JasXSL/VibHub-ESP32/README.md

# VibHub-ESP32
Beefing up the HW of VibHub

This is the firmware for the ESP32 version.
If you're looking for the API documentation, you can find that on the original VibHub client git: 
https://github.com/JasXSL/VibHub-Client/wiki

Official website: https://vibhub.io
