JasXSL/VibHub-ESP32/VibHub32_1.0/2.1/21c_2.png

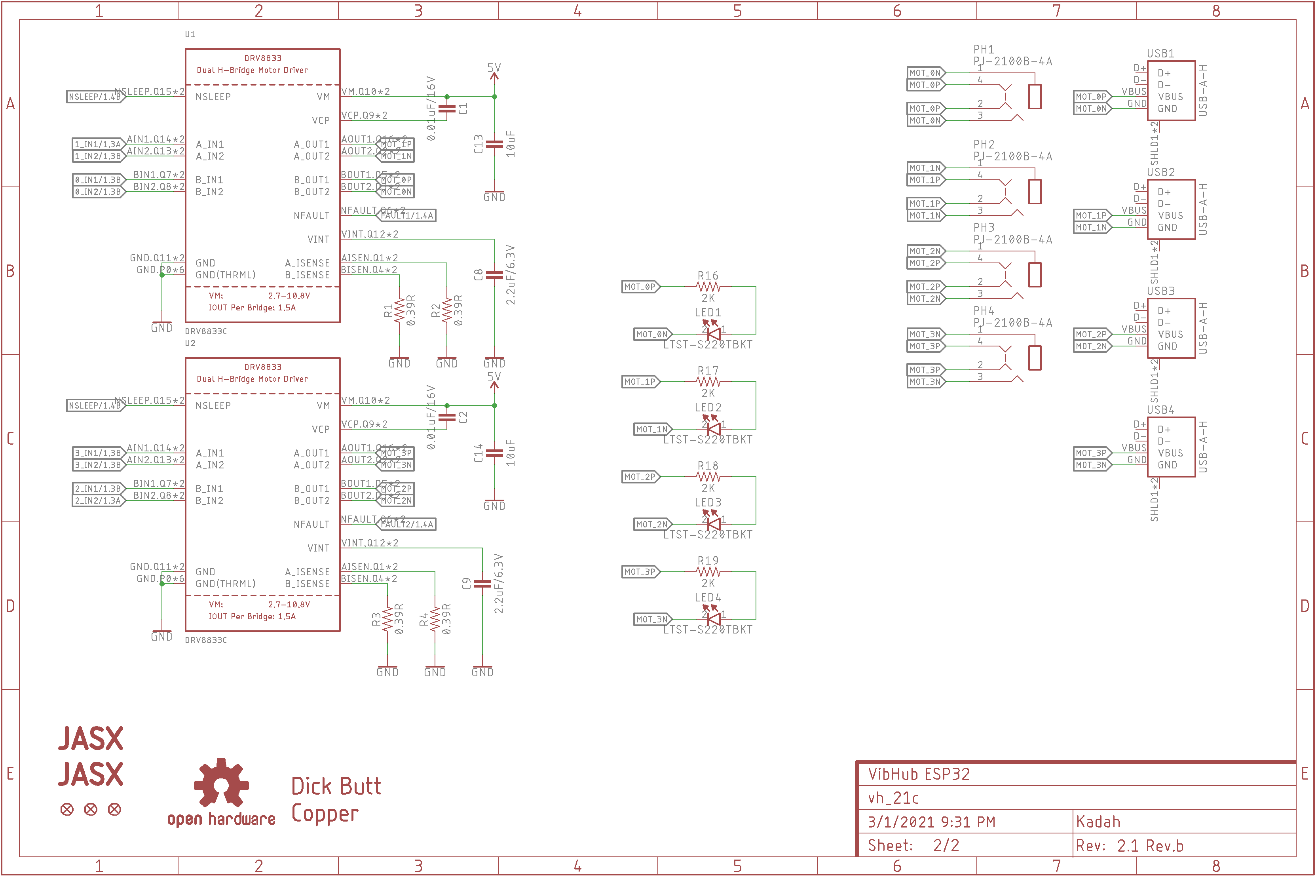
VibHub32_1.0/2.1/21c_2.png
