JasXSL/VibHub-ESP32/VibHub32_1.0/2.1/BOM.ods

Qty | Value | Device | Package | Parts | Description | Mgf | Mfg Part# | LCSC# | DigiKey# | Mouser# | Note
2 | 0.01uF (10nF) / 16V | CAPACITOR-0805 | C0805 | C1, C2 | Capacitors | Generic |  | C107135
3 | 10uF | CAPACITOR-0805 | C0805 | C12, C13, C14 | Capacitors | Generic |  | C15850
1 | 100uF / 10V | F931C107KCC | CAPPM6032X270N | C15 | Cap Tant Solid 100uF 16V C CASE 10% (6 X 3.2 X 2.5mm) Inward L SMD 6032-27 0.7 Ohm 125C T/R | AVX | F931C107KCC | C273664 | 478-8239-1-ND |  | Alt: C11375
2 | 0.1uF (100nF) | CAPACITOR-0805 | C0805 | C3, C4 | Capacitors | Generic |  | C1760
3 | 1.0uF | CAPACITOR-0805 | C0805 | C5, C6, C7 | Capacitors | Generic |  | C16834
4 | 2.2uF / 6.3V | CAPACITOR-0805 | C0805 | C8, C9, C10, C11 | Capacitors | Generic |  | C364318
1 | 1N4148W-7-F | DIODESOD-123 | SOD-123 | D1 | Diode | Diodes Incorporated | 1N4148W-7-F | C83528 | 1N4148W-7-F
2 | B340A-13-F | B340A | SMA | D3, D4 | Schottky diode | Diodes Incorporated | B340A-13-F | C85098 | B340A-FDICT-ND
1 | BAS70-05W,115 | BAS70-05SOT32 | SOT-23 | D5 | Silicon Schottky Diodes | Nexperia | BAS70-05W,115 | C34489 | 1727-4810-1-ND
1 | USBLC6-2SC6 | USBLC6-2SC6 | SOT-23-6 | ESD | TVS Diode Array Uni-Directional | STMicroelectronics | USBLC6-2SC6 | C7519 | 497-11882-1-ND |  | Optional, ESD protection for USB programming port
1 | 16V/2.5A | PPTC1812 | 1812 | F1 | Resettable Fuse PPTC | Bourns | MF-MSMF125-2 | C70120 | MF-MSMF125-2TR-ND |  | Any 1812 sized PTC between 2.2-2.5A
1 | DMG2305UX-13 | DMG2305UX-13 | SOT91P240X110-3 | Q1 | P-channel MOSFETs | Diodes Incorporated | DMG2305UX-13 | C144153 | DMG2305UX-13DICT-ND
1 | MBT3904DW1T1G | MBT3904DW1T1 | SC70-6 | Q2 | Dual NPN Transistors in Single Package | ON Semiconductor | MBT3904DW1T1G | C110150 | MBT3904DW1T1GOSCT-ND
1 | 2N7002,215 | MOSFET-NCH-BSS138 | SOT23-3 | Q3 | N-channel MOSFETs | Nexperia | 2N7002,215 | C65189 | 1727-2764-1-ND
4 | 0.30R to 0.40R | RESISTOR0805 | R0805 | R1, R2, R3, R4 | Generic Resistor Package | Generic |  | C247135 |  |  | Sets output current, see DRV8833 data sheet
2 | 22R | RESISTOR0805 | R0805 | R5, R6 | Generic Resistor Package | Generic |  | C107702
2 | 51R | RESISTOR0805 | R0805 | R7, R8 | Generic Resistor Package | Generic |  | C114537
5 | 220R | RESISTOR0805 | R0805 | R9, R10, R11, R12, R13 | Generic Resistor Package | Generic |  | C114519
2 | 1K | RESISTOR0805 | R0805 | R14, R15 | Generic Resistor Package | Generic |  | C100046
4 | 2K | RESISTOR0805 | R0805 | R16, R17, R18, R19 | Generic Resistor Package | Generic |  | C114748
12 | 10K | RESISTOR0805 | R0805 | R20, R21, R22, R23, R24, R25, R26, R27, R28, R29, R30, R31 | Generic Resistor Package | Generic |  | C84376
1 | >1M | RESISTOR0805 | R0805 | R32, R33 | Generic Resistor Package | Generic |  | C137463 |  |  | Pull-downs on battery input switching. 1M to 7M will work
2 | 150R (or 220R) | RESISTOR0805 | R0805 | R34, R35 | Generic Resistor Package | Generic |  | C114523 |  |  | 220R can be used instead to reuse existing BOM part
2 | DRV8833C | DRV8833 | HTSSOP16 or QFN16 | U1, U2 | DRV8833 Dual H-Bridge Motor Driver | Texas Instruments | DRV8833RTYR | C154936 | 296-29398-1-ND |  | HTSSOP16: C50506
1 | AP2112K-3.3V | V_REG_AP2112K-3.3V | SOT23-5 | U3 | 600mA CMOS LDO Regulator w/ Enable | Diodes Incorporated | AP2112K-3.3TRG1 | C51118 | AP2112K-3.3TRG1DICT-ND
1 | MAX16054AZT+T | MAX16054AZT+T | SOT95P275X110-6N | U4 | On Off Controller | Maxim Integrated | MAX16054AZT+T | C79401 | MAX16054AZT+TCT-ND |  | Optional if battery powered is not required
1 | CH340C | CH340C | SO016 | U5 | USB UART | WCH(Jiangsu Qin Heng) | CH340C | C84681 | I wish
4 | LTST-S220TBKT | LTST-S220TBKT | LTST-S220KFKT | LED1, LED2, LED3, LED4 | LED,0805,Side View,Blue,30mcd Lite-On LTST-S220TBKT Blue LED, 475 nm 2012 (0805) Side View, Rectangle Lens SMD package | Lite-On | LTST-S220TBKT-5A | C284936 | 160-2032-1-ND (too expensive, use standard 0805 LED instead) |  | Can be replaced with a standard 0805 LED
2 | RGB | LED-RGB-CAPLCC | P-LCC-4-3 | RGB1, RGB2 | LED-RGB Diffused Common Anode | Generic | 3528 RGB LED | C108539 | 732-4998-1-ND |  | https://www.aliexpress.com/item/32382711674.html
1 | ESP-WROOM32 | ESP-WROOM32 | ESP-WROOM32 | U6 | Espressif ESP-WROOM-32 | Espressif | ESP-WROOM-32 | C95209 | 1904-1010-1-ND
1 | USB-MICROB-2 | USB-MICROB-2 | USB-MICROB-10118194 | USB_IN | Micro USB Connector | Amphenol | 10118194-0001LF | C319164 | 609-4618-6-ND
2 | Right angle switch | MOMENTARY-SWITCH-SPST-RIGHTSQ75 | SW6X6_RIGHT_SQ73 | CONFIG, POWER | 6x6 right angle tact switch | Generic |  | C127680
2 | SMD tact switch | MOMENTARY-SWITCH-SPST-SMD-6.0X3.5MM | TACTILE_SWITCH_SMD_6.0X3.5MM | FLASH, RESET | SMD tact switch | Generic |  | C329185 |  |  | Or anything like this. Common button type. Can use different colors for flash and config to be fancy.
4* | USB-A-H | USB-A-H | USB-A-H | USB1, USB2, USB3, USB4 | USB Type A connector | Generic |  | C2346 |  |  | Pick any combination of 2.5mm and USB for a total of 4
4* | PJ-2100B-4A | PJ-2100B-4A | PJ2100B4A | PH1, PH2, PH3, PH4 | 2.5mm audio jack | Korean Hroparts Elec | PJ-2100B-4A | C145822 |  |  | “
4 | 596 | KEYSTONE_596 | THT | BATT_POS | Cylindrical Battery Contact | Keystone | 596 | C238144 | 36-596-ND | 534-596
4 | 590 | KEYSTONE_590 | THT | BATT_NEG | Cylindrical Battery Contact | Keystone | 590 | N/A as of May 2020 | 36-590-ND | 534-590
