JasXSL/VibHub-ESP32/VibHub32_1.0/2.1/Mini BOM.ods

Qty | Value | Package | Parts
2 | 0.01uF/16V | C0805 | C1, C2
3 | 10uF | C0805 | C12, C13, C14
1 | 100uF/10V | CAPPM | C15
2 | 0.1uF | C0805 | C3, C4
3 | 1.0uF | C0805 | C5, C6, C7
4 | 2.2uF/6.3V | C0805 | C8, C9, C10, C11
1 | 1N4148W-7-F | SOD-123 | D1
2 | B340A | SMA | D3, D4
1 | BAS70 | SOT-23 | D5
1 | USBLC6-2SC6 | SOT-23-6 | ESD
1 | 16V/2.2A | 1812 | F1
1 | DMG2305UX-13 | SOT-23 | Q1
1 | MBT3904DW1T1 | SC70-6 | Q2
1 | 2N7002,215 | SOT-23 | Q3
4 | 0.36R to 0.40R | R0805 | R1, R2, R3, R4
2 | 22R | R0811 | R5, R6
2 | 51R | R0813 | R7, R8
5 | 220R | R0810 | R9 thru R13
2 | 1K | R0809 | R14, R15
4 | 2K | R0812 | R16, R17, R18, R19
12 | 10K | R0807 | R20 thru R31
1 | >1M | R0806 | R32, R33
2 | 150R (or 220R) | R0808 | R34, R35
2 | DRV8833C | COMBO | U1, U2
1 | AP2112K-3.3V | SOT-23-5 | U3
1 | MAX16054AZT+T | SOT-23-6 | U4
1 | CH340C | SO-16 | U5
4 | LTST-S220TBKT | 2.1x1x0.6 | LED1 thru LED4
2 | RGB | P-LCC-4-3 | RGB1, RGB2
1 | ESP-WROOM32 | WROOM32 | U6
