JasXSL/VibHub-ESP32/VibHub32_1.0/2.0a/BOM.ods

Qty | Value | Device | Package | Parts | Description | DIGIKEY | PROD_ID | VALUE
1 | BC4AAPCBC4AAPC | BC4AAPCBC4AAPC | BC4AAPC | BAT
2 | 0.01uF/16V | CAPACITOR-0805 | C0805 | C1, C2 | Capacitors
1 | 4.7uF | CAPACITOR-0805 | C0805 | C12 | Capacitors
3 | 10uF | CAPACITOR-0805 | C0805 | C13, C14, C15 | Capacitors
1 | 100uF/10V | CAPACITOR_POLPANASONIC_D | PANASONIC_D | C16 | Polarized Capacitors
2 | 0.1uF | CAPACITOR-0805 | C0805 | C3, C4 | Capacitors
3 | 1.0uF | CAPACITOR-0805 | C0805 | C5, C6, C7 | Capacitors
4 | 2.2uF/6.3V | CAPACITOR-0805 | C0805 | C8, C9, C10, C11 | Capacitors
4 | MJ-2509N | MJ-2509N | MJ-2509N | CH_0, CH_1, CH_2, CH_3 | Mono Audio Jack, 2.5 MM
4 | USB-A-H | USB-A-H | USB-A-H | CH_0U, CH_1U, CH_2U, CH_3U | USB Connectors
4 | MOMENTARY-SWITCH-SPST-RIGHTSQ75 | MOMENTARY-SWITCH-SPST-RIGHTSQ75 | SW6X6_RIGHT_SQ73 | CONFIG, FLASH, POWER, RESET
1 | RGB | LED-RGB-CAPLCC | P-LCC-4-3 | D1 | LED-RGB Diffused Common Anode |  | DIO-12986 | RGB
2 | 3A/40V/500mV | DIODE-SCHOTTKY-B340A | SMA-DIODE | D2, D3 | Schottky diode |  | DIO-09886 | 3A/40V/500mV
1 | BAS70-05SOT32 | BAS70-05SOT32 | SOT91P240X110-3 | D4 | Silicon Schottky Diodes
1 | D_ESD5V3U2U-03F | D_ESD5V3U2U-03F | SOT723 | D5 | TVS Diode - Uni-directional Ultra Low ESD / Transient Protection Diode | ESD5V3U2U-03F H6327DKR-ND
8 | Blue | LED0805 | CHIPLED_0805 | D6, D7, D8, D9, D10, D11, D12, D13 | LED (Generic)
1 | 16V/2.2A | PPTC1812 | FUSC7035X90 | F1 | Resettable Fuse PPTC
1 | USB-MICROB-2 | USB-MICROB-2 | USB-MICROB-10118194 | J1 | USB Connectors | 609-4618-6-ND
3 |  | CONN_07X2 | 2X7 | J2, J6, J7 | Multi connection point. Often used as Generic Header-pin footprint for 0.1 inch spaced/style header connections
1 |  | CONN_04 | 1X04 | J3 | Multi connection point. Often used as Generic Header-pin footprint for 0.1 inch spaced/style header connections |  | CONN-09696
1 | 1x8M | CONN_06LOCK | 1X06_LOCK | PROG | Multi connection point. Often used as Generic Header-pin footprint for 0.1 inch spaced/style header connections
1 | MOSFET_PCH-DMG2305UX-13 | MOSFET_PCH-DMG2305UX-13 | SOT91P240X110-3 | Q1 | P-channel MOSFETs
1 |  | TRANS_NPN_DUAL-MBT3904DW1T1 | SC70-6 | Q2 | Dual NPN Transistors in Single Package |  | TRANS-13337
4 | 0.39R | RESISTOR0805 | 805 | R1, R2, R3, R4 | Generic Resistor Package
10 | 1K | RESISTOR0805 | 805 | R11, R12, R13, R14, R15, R16, R17, R18, R19, R20 | Generic Resistor Package
12 | 10K | RESISTOR0805 | 805 | R21, R22, R23, R24, R25, R26, R27, R28, R29, R30, R31, R32 | Generic Resistor Package
1 | 15K | RESISTOR0805 | 805 | R33 | Generic Resistor Package
3 | 100K | RESISTOR0805 | 805 | R34, R35, R36 | Generic Resistor Package
1 | 22R | RESISTOR0805 | 805 | R5 | Generic Resistor Package
1 | 51R | RESISTOR0805 | 805 | R6 | Generic Resistor Package
4 | 220R | RESISTOR0805 | 805 | R7, R8, R9, R10 | Generic Resistor Package
2 | DRV8833C | DRV8833 | HTSSOP16 | U1, U2 | DRV8833 Dual H-Bridge Motor Driver -- HTSSOP Package
1 | 3.3V | V_REG_AP2112K-3.3V | SOT23-5 | U3 | AP2112 - 600mA CMOS LDO Regulator w/ Enable |  | VREG-12457 | 3.3V
1 | CP2102N-QFN24 | CP2102N-QFN24 | QFN24-PAD | U4 | Silabs CP2102N USB to UART Bridge (5V tolerant inputs)
1 | 4093SO14 | 4093SO14 | SOIC127P600X175-14 | U5 | Quad 2-input NAND schmitt trigger
1 | ESP-WROOM32 | ESP-WROOM32 | ESP-WROOM32 | U6 | Espressif ESP-WROOM-32 ESP32 WiFi/WLAN + Bluetooth/BLE Module
