JasXSL/VibHub-ESP32/VibHub32_1.0/2.0a/Case/Case Bottom.stl

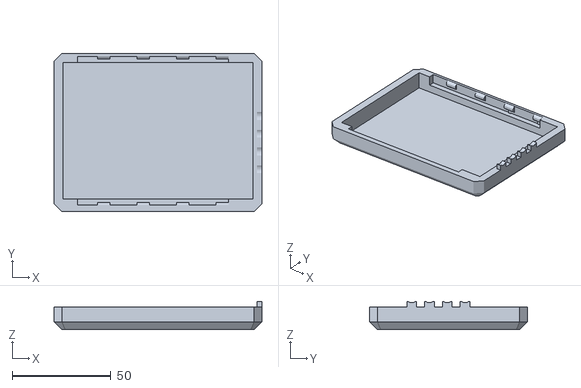
[picture p3: CAD file, 2019-07-22]
VibHub32_1.0/2.0a/Case/Case Bottom.stl
105.1 x 79.9 x 14.4
