JasXSL/VibHub-ESP32/VibHub32_1.0/2.0a/Case/With Logo/Case Top - Logo.stl

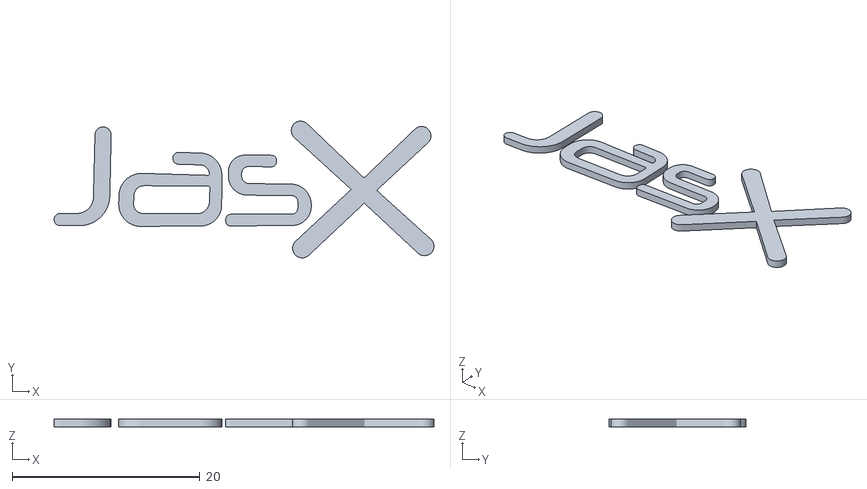
[picture p4: CAD file, 2019-07-22]
VibHub32_1.0/2.0a/Case/With Logo/Case Top - Logo.stl
40.5 x 14.6 x 0.8
