JasXSL/VibHub-ESP32/VibHub32_1.0/2.1/Case/Bottom_Tight.stl

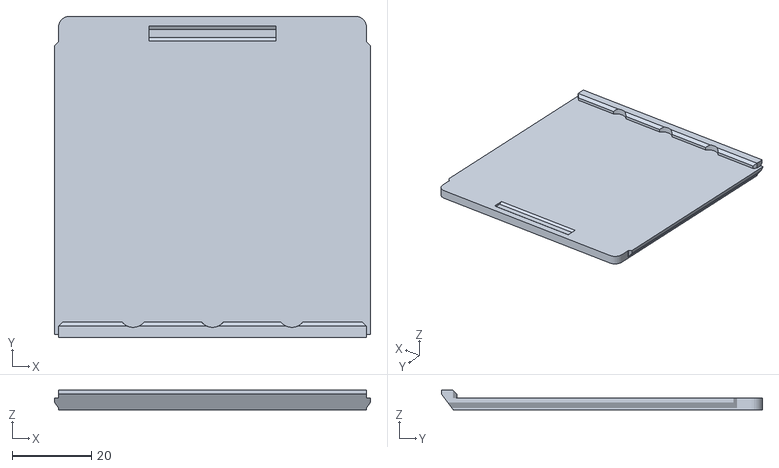
[picture p5: CAD file, 2020-05-22]
VibHub32_1.0/2.1/Case/Bottom_Tight.stl
79.6 x 80.9 x 4.95
