JasXSL/VibHub-ESP32/VibHub32_1.0/2.1/Case/Top v12 Thinner Face Multi Material/Top_Vibhub 2.1c Case rev F v12_22_Top.stl

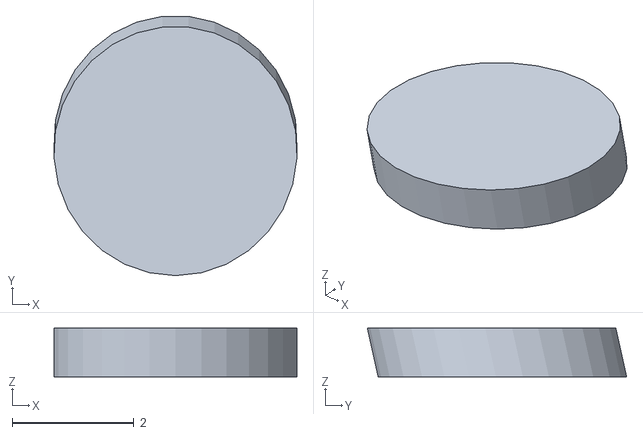
[picture p7: CAD file, 2020-05-22]
VibHub32_1.0/2.1/Case/Top v12 Thinner Face Multi Material/Top_Vibhub 2.1c Case rev F v12_22_Top.stl
3.99 x 4.26 x 0.8
