JasXSL/VibHub-ESP32/VibHub32_1.0/2.1/Case/Top v9 Thiner Logo Multi Material/Top_Vibhub 2.1c Case rev F v9_l6_Top.stl

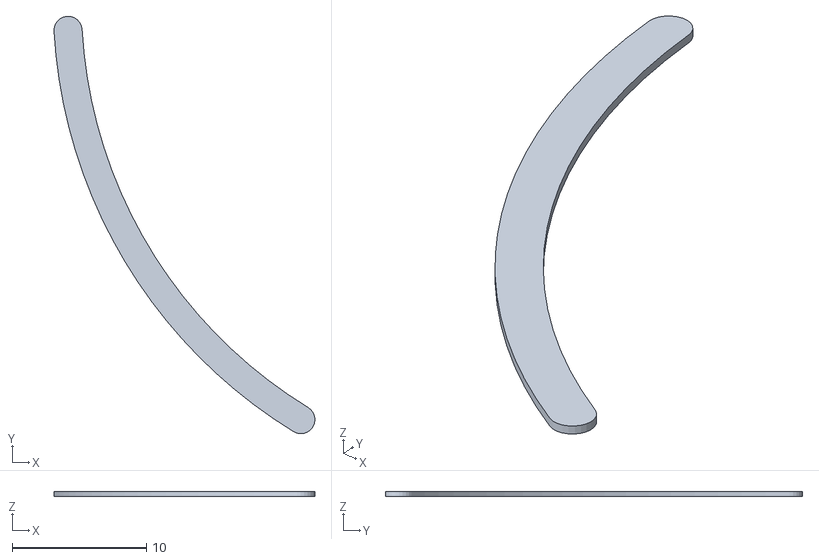
[picture p8: CAD file, 2020-05-19]
VibHub32_1.0/2.1/Case/Top v9 Thiner Logo Multi Material/Top_Vibhub 2.1c Case rev F v9_l6_Top.stl
19.4 x 31.1 x 0.4
