JasXSL/VibHub-ESP32/VibHub32_1.0/2.0a/Case/Port Jig.stl

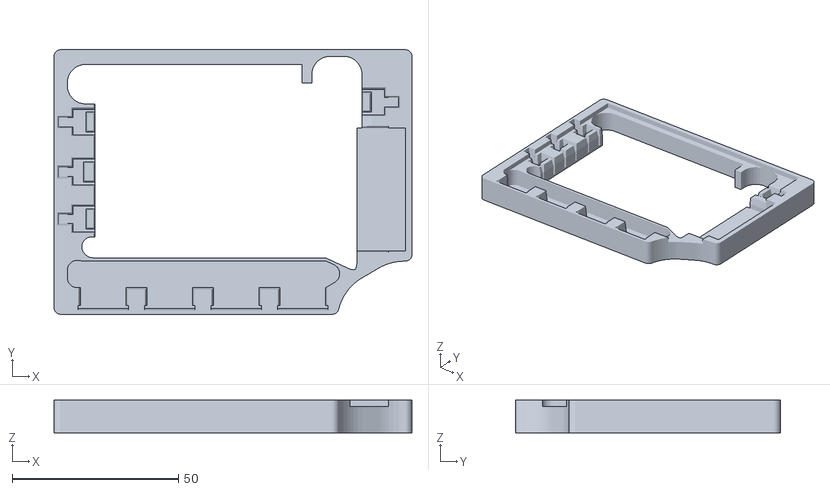
[picture p9: CAD file, 2019-07-22]
VibHub32_1.0/2.0a/Case/Port Jig.stl
107.7 x 79.6 x 9.92
