JasXSL/VibHub-ESP32/VibHub32_1.0/2.0a/Case/With Logo/Case Top - No Vents.stl

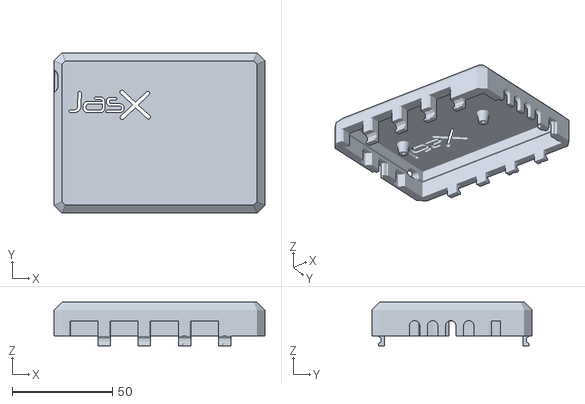
[picture p10: CAD file, 2019-07-22]
VibHub32_1.0/2.0a/Case/With Logo/Case Top - No Vents.stl
105.1 x 79.9 x 21.9
