JasXSL/VibHub-ESP32/VibHub32_1.0/2.1/Case/Top Single.stl

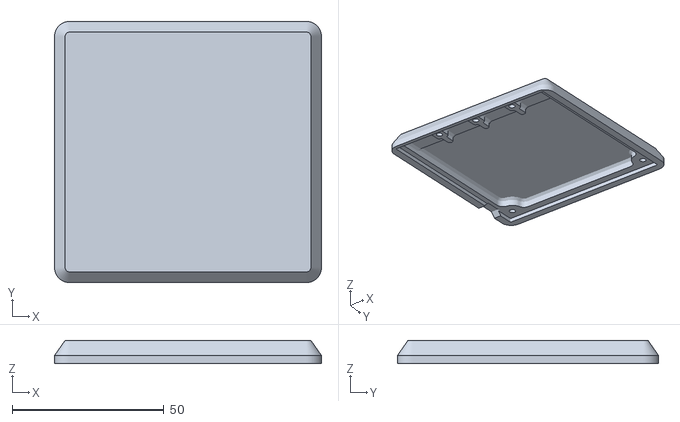
[picture p11: CAD file, 2020-05-19]
VibHub32_1.0/2.1/Case/Top Single.stl
88.0 x 86.1 x 7.67
