JasXSL/VibHub-ESP32/VibHub32_1.0/2.1/Case/Top v10 Thiner Logo Thinner Face Multi Material/Top_Vibhub 2.1c Case rev F v10_vb_Top.stl

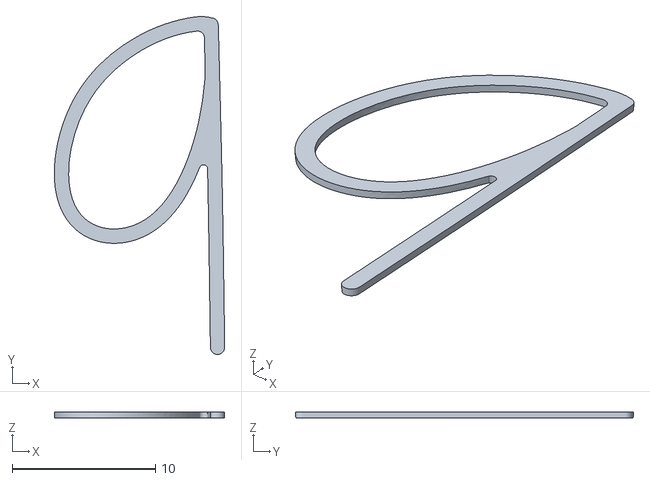
[picture p12: CAD file, 2020-05-22]
VibHub32_1.0/2.1/Case/Top v10 Thiner Logo Thinner Face Multi Material/Top_Vibhub 2.1c Case rev F v10_vb_Top.stl
11.9 x 23.6 x 0.4
