JasXSL/VibHub-ESP32/VibHub32_1.0/2.1/Case/Top v12 Thinner Face Multi Material/Top_Vibhub 2.1c Case rev F v12_33_Top.stl

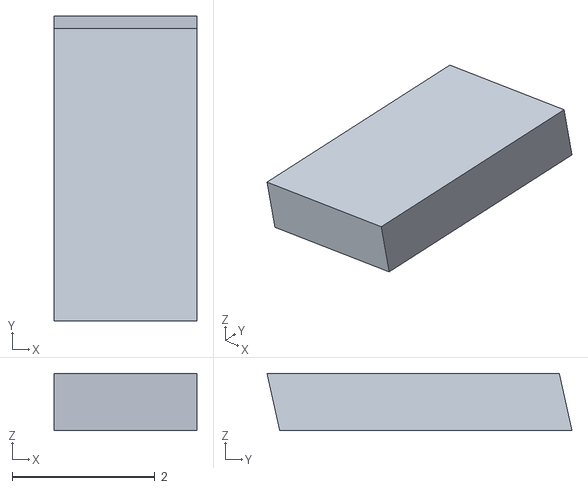
[picture p13: CAD file, 2020-05-22]
VibHub32_1.0/2.1/Case/Top v12 Thinner Face Multi Material/Top_Vibhub 2.1c Case rev F v12_33_Top.stl
2.00 x 4.27 x 0.8
