JasXSL/VibHub-ESP32/VibHub32_1.0/2.0a/Case/Buttons.stl

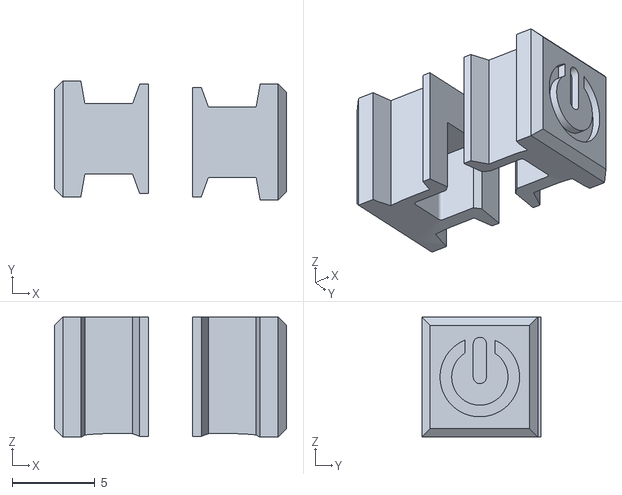
[picture p15: CAD file, 2019-07-22]
VibHub32_1.0/2.0a/Case/Buttons.stl
14.0 x 7.20 x 7.23
