JasXSL/VibHub-ESP32/VibHub32_1.0/2.1/Case/Buttons.stl

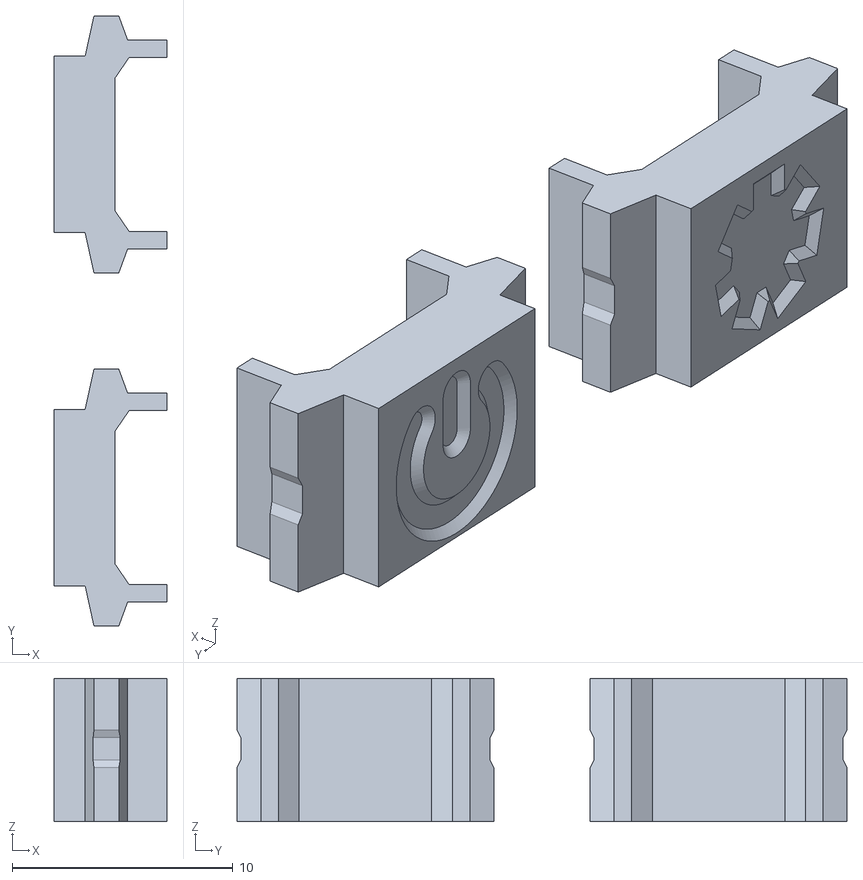
[picture p16: CAD file, 2020-05-19]
VibHub32_1.0/2.1/Case/Buttons.stl
5.10 x 27.6 x 6.50
