JasXSL/VibHub-ESP32/VibHub32_1.0/2.1/Case/Top v10 Thiner Logo Thinner Face Multi Material/Top_Vibhub 2.1c Case rev F v10_hb_Top.stl

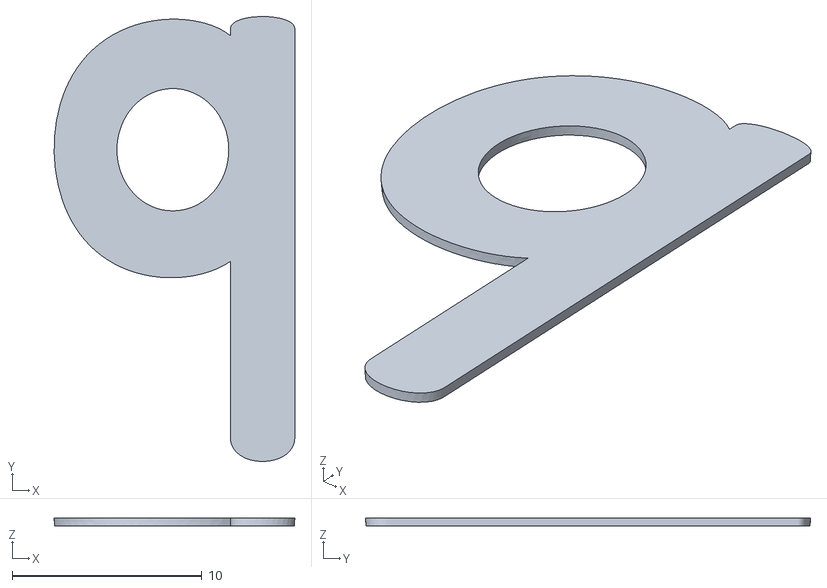
[picture p17: CAD file, 2020-05-22]
VibHub32_1.0/2.1/Case/Top v10 Thiner Logo Thinner Face Multi Material/Top_Vibhub 2.1c Case rev F v10_hb_Top.stl
12.7 x 23.5 x 0.4
