JasXSL/VibHub-ESP32/VibHub32_1.0/2.1/Case/Top v12 Thinner Face Multi Material/Top_Vibhub 2.1c Case rev F v12_l10_Top.stl

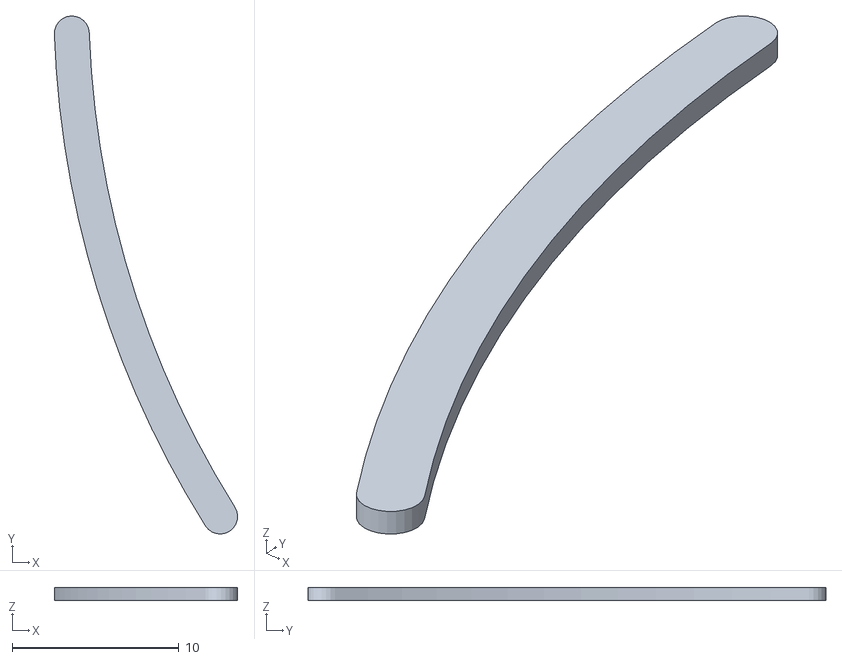
[picture p18: CAD file, 2020-05-22]
VibHub32_1.0/2.1/Case/Top v12 Thinner Face Multi Material/Top_Vibhub 2.1c Case rev F v12_l10_Top.stl
11.0 x 31.1 x 0.8
