JasXSL/VibHub-ESP32/VibHub32_1.0/2.1/Case/Top v9 Thiner Logo Multi Material/Top_Vibhub 2.1c Case rev F v9_42_Top.stl

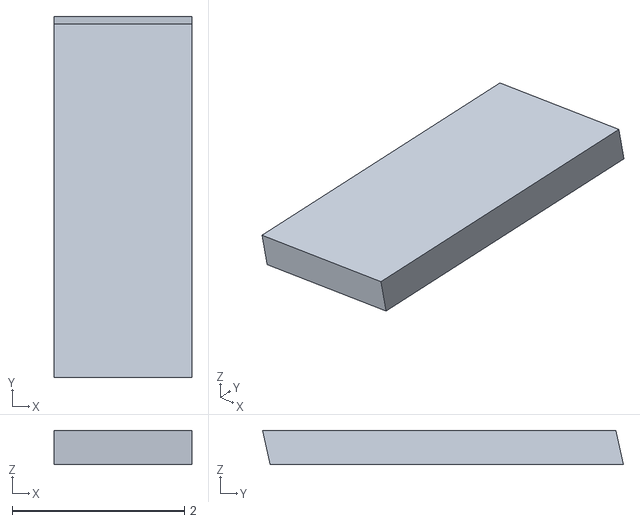
[picture p19: CAD file, 2020-05-19]
VibHub32_1.0/2.1/Case/Top v9 Thiner Logo Multi Material/Top_Vibhub 2.1c Case rev F v9_42_Top.stl
1.60 x 4.19 x 0.4
