JasXSL/VibHub-ESP32/VibHub32_1.0/2.1/Case/Buttons_Vibhub 2.1c Case rev F v2_Config_Buttons.stl

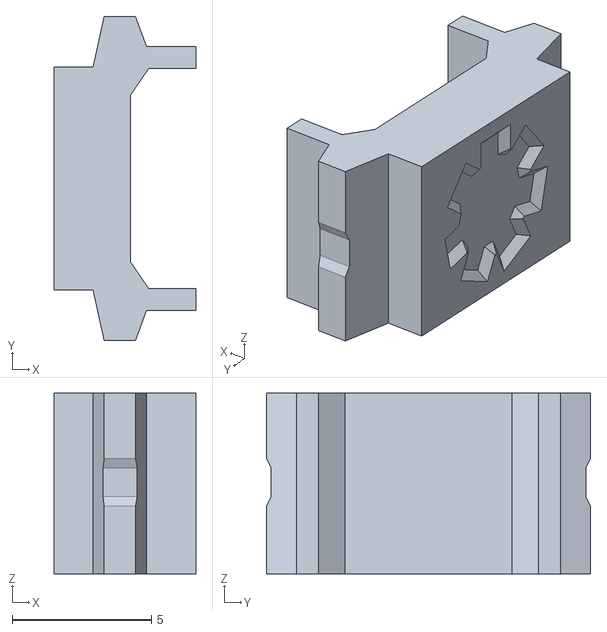
[picture p20: CAD file, 2020-05-19]
VibHub32_1.0/2.1/Case/Buttons_Vibhub 2.1c Case rev F v2_Config_Buttons.stl
5.10 x 11.6 x 6.50
