JasXSL/VibHub-ESP32/VibHub32_1.0/2.1/Case/Top v10 Thiner Logo Thinner Face Multi Material/Top_Vibhub 2.1c Case rev F v10_l2_Top.stl

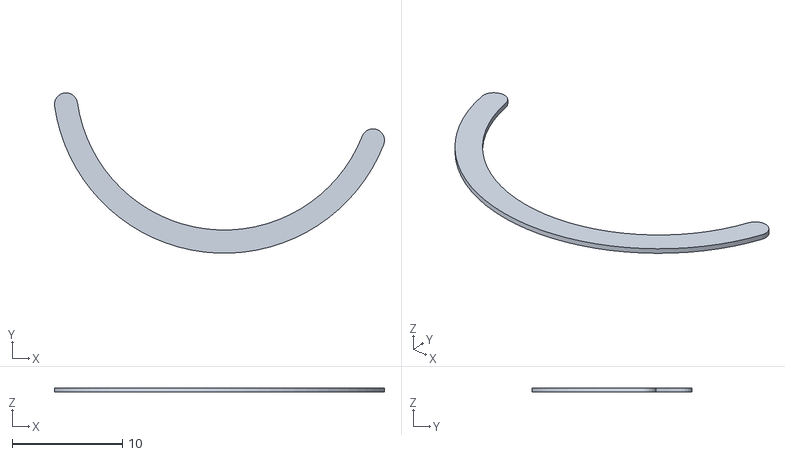
[picture p21: CAD file, 2020-05-22]
VibHub32_1.0/2.1/Case/Top v10 Thiner Logo Thinner Face Multi Material/Top_Vibhub 2.1c Case rev F v10_l2_Top.stl
29.9 x 14.5 x 0.4
