JasXSL/VibHub-ESP32/VibHub32_1.0/2.1/Case/Top v12 Thinner Face Multi Material/Top_Vibhub 2.1c Case rev F v12_vv_Top.stl

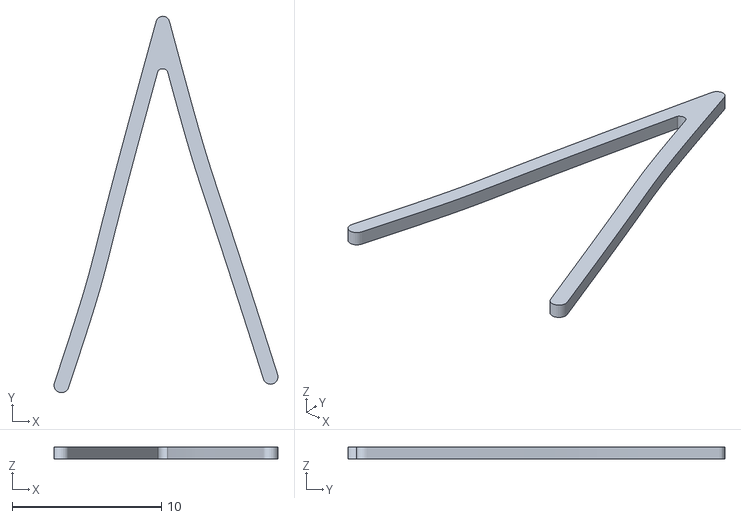
[picture p23: CAD file, 2020-05-22]
VibHub32_1.0/2.1/Case/Top v12 Thinner Face Multi Material/Top_Vibhub 2.1c Case rev F v12_vv_Top.stl
15.0 x 25.2 x 0.8
