JasXSL/VibHub-ESP32/VibHub32_1.0/2.1/Case/Middle.stl

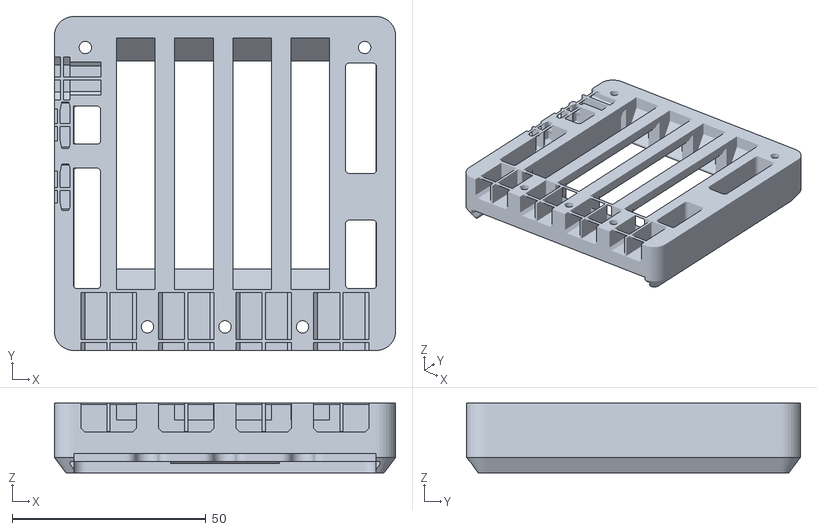
[picture p25: CAD file, 2020-05-19]
VibHub32_1.0/2.1/Case/Middle.stl
88.0 x 86.1 x 18.0
