JasXSL/VibHub-ESP32/VibHub32_1.0/2.1/Case/Top v10 Thiner Logo Thinner Face Multi Material/Top_Vibhub 2.1c Case rev F v10_l7_Top.stl

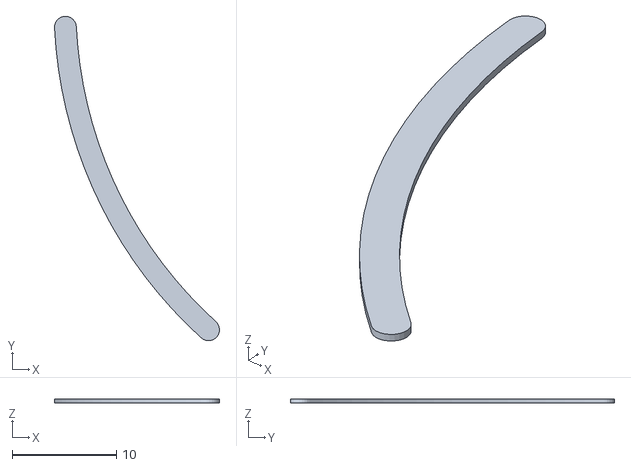
[picture p26: CAD file, 2020-05-22]
VibHub32_1.0/2.1/Case/Top v10 Thiner Logo Thinner Face Multi Material/Top_Vibhub 2.1c Case rev F v10_l7_Top.stl
15.8 x 31.1 x 0.4
