JasXSL/VibHub-ESP32/VibHub32_1.0/2.1/Case/Top v9 Thiner Logo Multi Material/Top_Vibhub 2.1c Case rev F v9_l5_Top.stl

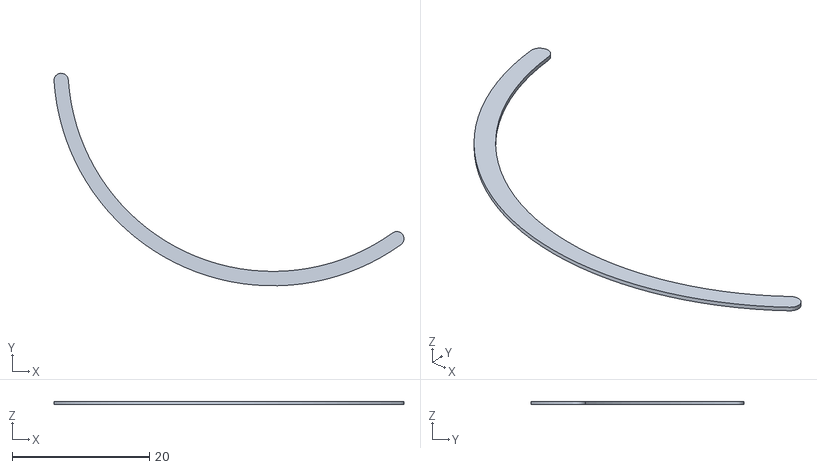
[picture p27: CAD file, 2020-05-19]
VibHub32_1.0/2.1/Case/Top v9 Thiner Logo Multi Material/Top_Vibhub 2.1c Case rev F v9_l5_Top.stl
51.0 x 30.9 x 0.4
