JasXSL/VibHub-ESP32/VibHub32_1.0/2.1/Case/2.5mm Jack.stl

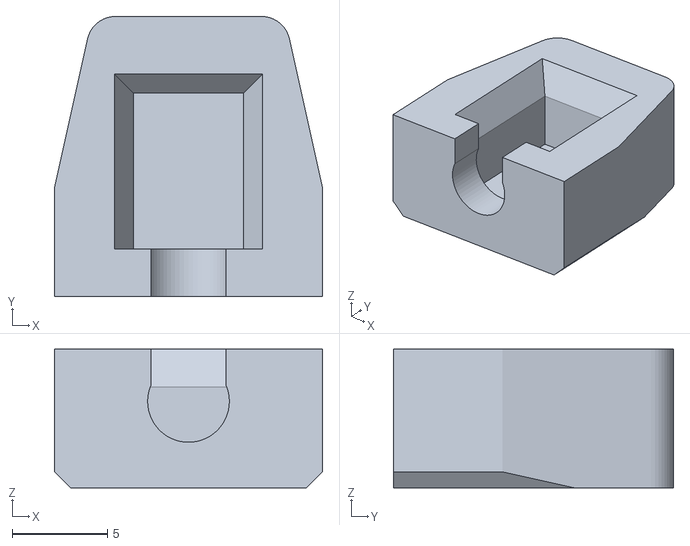
[picture p28: CAD file, 2020-05-19]
VibHub32_1.0/2.1/Case/2.5mm Jack.stl
14.1 x 14.7 x 7.30
