JasXSL/VibHub-ESP32/(threads)

Thread 1 (2018-08-25):

Programs crash the whole thing.

JasXSL, 2018-08-25:
Sending programs crashes the whole thing. I've made a comment where the crash occurs and added a "todo".

JasXSL, 2018-08-25:
Issue was caused by only setting up 1 motor, all 4 were needed for the loops. Fixed.

Closed 2018-08-25.

Thread 2 (2018-08-25):

Todo for Kadah

JasXSL, 2018-08-25:
- [x] Re-implement motor reversal. The old code is there, just commented out, search the code for "kadah".
- [x] Add pwm.enable and pwm.disable to the new PWM system.
- [x] Try to implement OTA

Kadah, 2018-08-25:
pwm.enable/pwm.disable globally turns off the motor driver enable line. I use this for state changes. On the ESP8266 board, the power on state of the PWM chip might cause the motor outputs to be on, the enabled line makes sure our outputs are actually off when we expect them to be (setup mode, offline, etc). Only requires a single digital line, so I plan to keep it.

Kadah, 2018-08-26:
OTA is entirely possible. Need to discuss how we want it to be initiated. Currently have it server initiated via "ota" socket event with "file" and "md5" fields, bin files hosted on github releases.

An autoupdater is also possible. Could have it check for updates on connect and download from the server.

Basically anything where it downloads the bin from a webserver should be doable. Using HTTPS would be a good idea and long term we might want the update server to have its own self-signed cacert with a very long expiry as the public key needs to be baked in to the firmware.

Kadah, 2018-08-31:
ESP8266 updates downloading over HTTP(S) is not proving to be doable. It should work, but I cannot get it to work. The few server examples are old and predate the current ESP8266httpUpdate that requires a x-MD5. Even after adding that, the received firmware bin is failing the magic header tests and I cannot track down why.
I'm giving up making the ESP8266 support being able to download firmware updates itself. I might test using the ESP8266's internal web server to upload bins to it instead via a browser.

Since we are EOLing the ESP8266 version for the ESP32, ez updating isn't a huge concern.

Closed 2018-11-07.

Thread 3 (2018-08-25):

Jas todo list

JasXSL, 2018-08-25:
- [x] Implement HW random
- [x] The CSS is bork in the latest version of wifimanager. Fix this.
- [x] Put ESP in deep sleep if autoconnect fails. Maybe show a permanent red light of death if doable.
- [x] Improve tweening so each repeat doesn't need to generate an additional stage in the tween, conserving memory.
- [x] Captive portal E-manual

Closed 2018-11-07.

Thread 6 (2018-11-07):

Board Design

JasXSL, 2018-11-07:
After revision 2 is available to testers. What should rev 3 look like?

### Suggestion:
Make a prototype board we can sell to a larger audience. Going "bare minimum" and simplifying for end users. Such as:

### Components:
- Limit LEDs to 1 RGB for device status. Maybe 2? One blue like the esp8266 built in one?
- What header pins do we need? Is it enough with the 6 needed to connect and upload firmware?
- Use 2x USB ports and 2x phono. All on their own channel. Less confusing if a user has both a USB and phono toy and can't figure out why it doesn't work because they plugged in both on the same channel.
- Do we have a fuse?
- Only 2 outwards facing inputs: Slide switch for power, push button for config. 2 Small buttons on the inside for power and boot mode select.

### Layout:
- Possible to fit 2x USB and 2x Phono ports on one end, config stuff on the other?
- Micro USB centered, switch and button next to it?

Thread 13 (2019-02-02):

Bluetooth factory reset

JasXSL, 2019-02-02:
https://github.com/nkolban/esp32-snippets/issues/804

JasXSL, 2019-02-05:
DONE

Closed 2019-02-05.
