JasXSL/VibHub-ESP32/VibHub32_1.0/2.1/vh_21c.brd

## EAGLE design VibHub32_1.0/2.1/vh_21c.brd (2020-05-19)

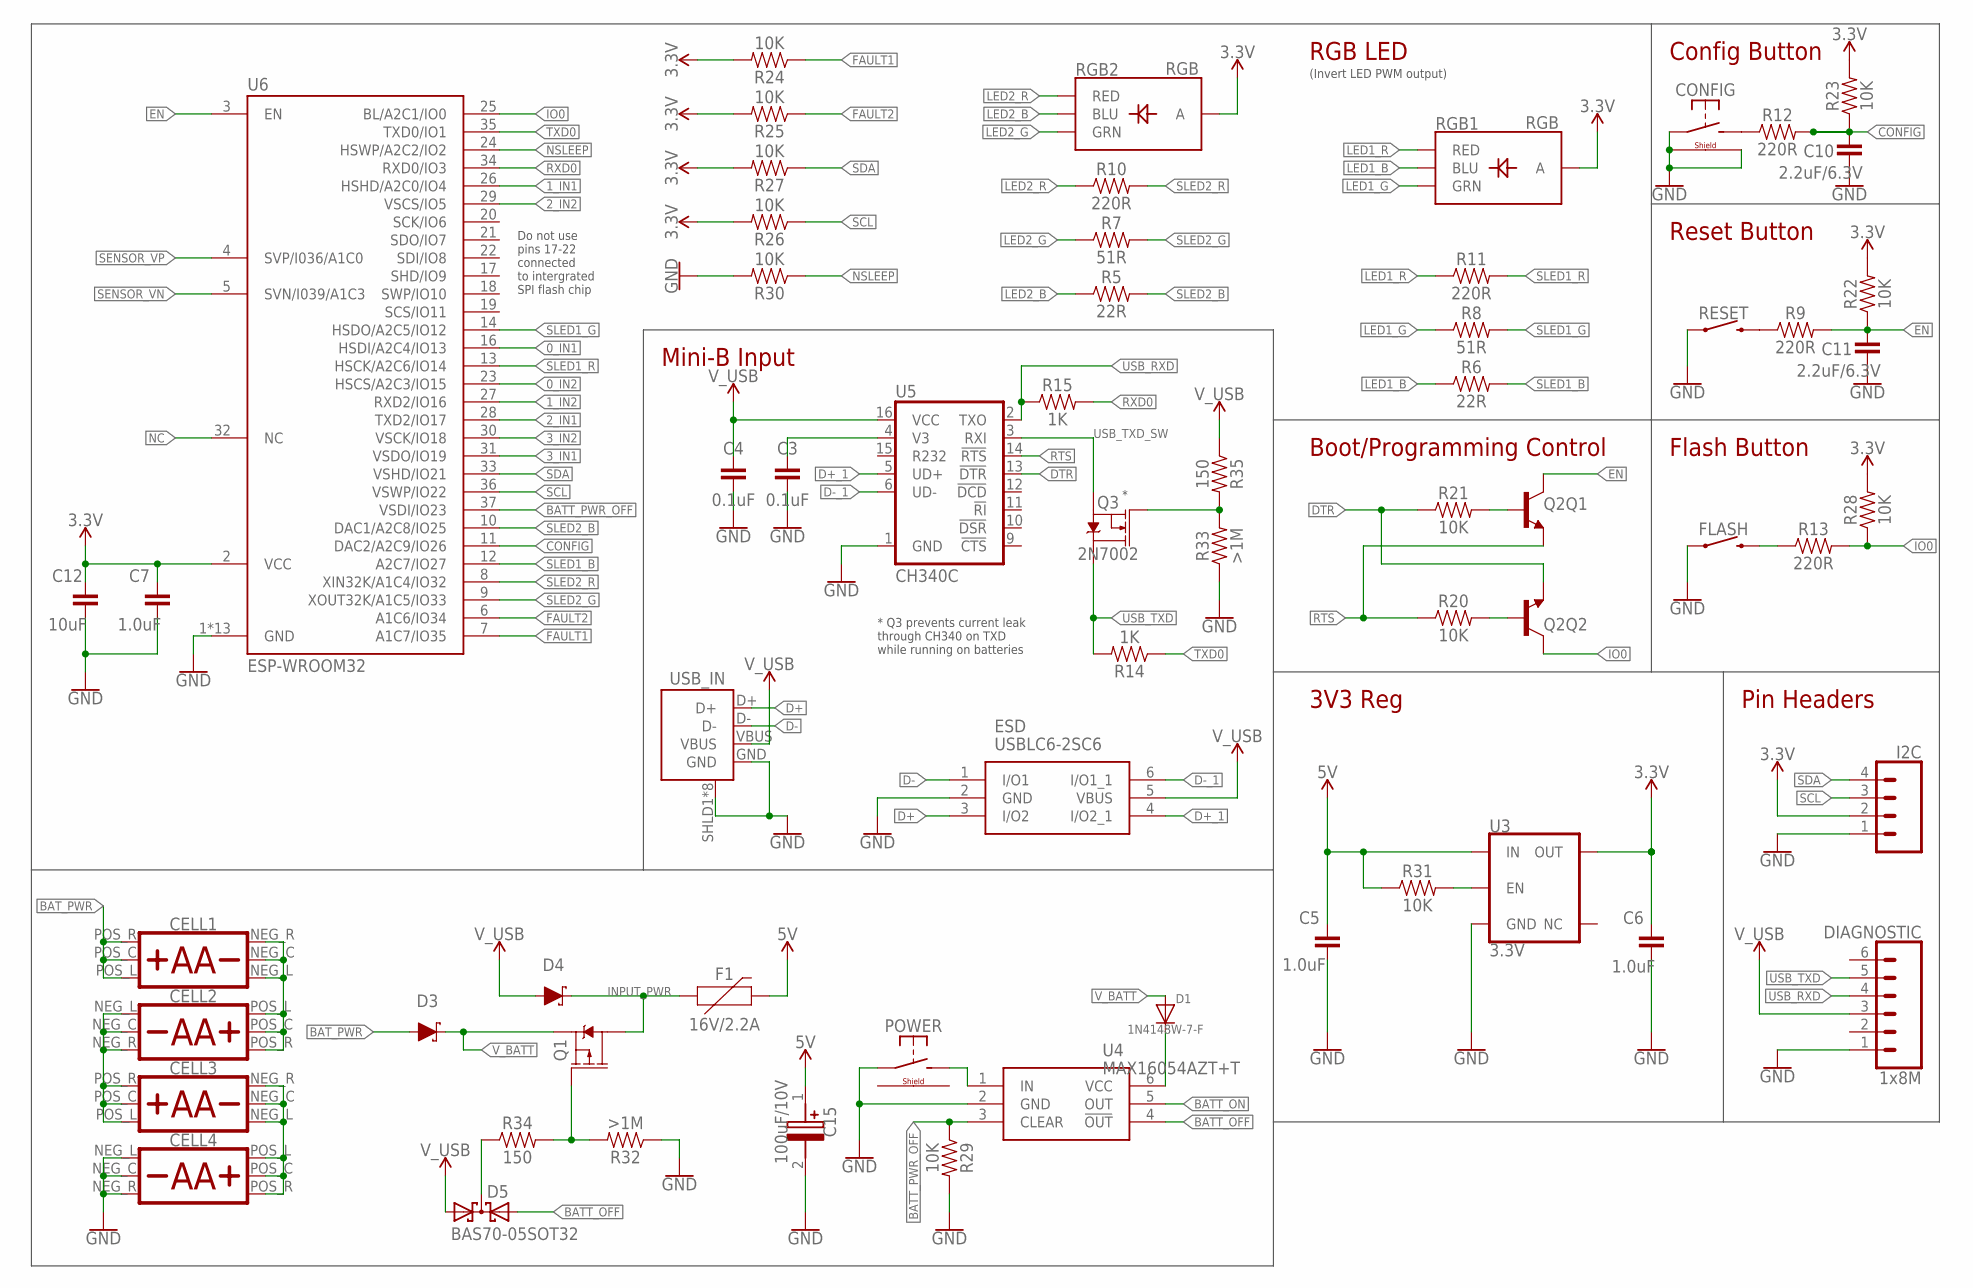
[picture p56: schematic vh_21c.sch, sheet 1]

Parts:
C3, C4: 0.1uF; C0805
C5, C6, C7: 1.0uF; C0805
C10, C11: 2.2uF/6.3V; C0805
C12: 10uF; C0805
C15: 100uF/10V; CAPPM6032X270N
CELL1, CELL2, CELL3, CELL4: AA_590_596
CONFIG: MOMENTARY-SWITCH-SPST-RIGHTSQ75; SW6X6_RIGHT_SQ73
D1: 1N4148W-7-F; SOD-123
D3, D4: 3A/40V/500mV; SMA-DIODE
D5: BAS70-05SOT32; SOT91P240X110-3
DIAGNOSTIC: 1x8M; 1X06_LOCK
ESD: USBLC6-2SC6; SOT95P280X145-6N
F1: 16V/2.2A; FUSC7035X90
FLASH: MOMENTARY-SWITCH-SPST-SMD-6.0X3.5MM; TACTILE_SWITCH_SMD_6.0X3.5MM
I2C: CONN_04; 1X04
POWER: MOMENTARY-SWITCH-SPST-RIGHTSQ75; SW6X6_RIGHT_SQ73
Q1: MOSFET_PCH-DMG2305UX-13; SOT91P240X110-3
Q2: TRANS_NPN_DUAL-MBT3904DW1T1; SC70-6
Q3: 2N7002; SOT23-3
R5, R6: 22R; 0805
R7, R8: 51R; 0805
R9, R10, R11, R12, R13: 220R; 0805
R14, R15: 1K; 0805
R20, R21, R22, R23, R24, R25, R26, R27, R28, R29, R30, R31: 10K; 0805
R32, R33: >1M; 0805
R34, R35: 150; 0805
RESET: MOMENTARY-SWITCH-SPST-SMD-6.0X3.5MM; TACTILE_SWITCH_SMD_6.0X3.5MM
RGB1, RGB2: RGB; P-LCC-4-3
U3: 3.3V; SOT23-5
U4: MAX16054AZT+T; SOT95P275X110-6N
U5: CH340C; SO016
U6: ESP-WROOM32
USB_IN: USB-MICROB-2; USB-MICROB-10118194

Connections:
0_IN1: U6.16 (HSDI/A2C4/IO13); also elsewhere on the board
0_IN2: U6.23 (HSCS/A2C3/IO15); also elsewhere on the board
1_IN1: U6.26 (HSHD/A2C0/IO4); also elsewhere on the board
1_IN2: U6.27 (RXD2/IO16); also elsewhere on the board
2_IN1: U6.28 (TXD2/IO17); also elsewhere on the board
2_IN2: U6.29 (VSCS/IO5); also elsewhere on the board
3.3V: C6.1, C7.1, C12.1, I2C.2, R22.2, R23.2, R24.2, R25.2, R26.2, R27.2, R28.2, RGB1.4 (A), RGB2.4 (A), U3.5 (OUT), U6.2 (VCC)
3_IN1: U6.31 (VSDO/IO19); also elsewhere on the board
3_IN2: U6.30 (VSCK/IO18); also elsewhere on the board
5V: C5.1, C15.1 (+), F1.2, R31.1, U3.1 (IN); also elsewhere on the board
BATT_OFF: D5.2 (A2), U4.4 (!OUT)
BATT_ON: U4.5 (OUT)
BATT_PWR_OFF: R29.1, U4.3 (CLEAR), U6.37 (VSDI/IO23)
BAT_PWR: CELL1.POS_C, CELL1.POS_L, CELL1.POS_R, D3.A
CONFIG: C10.1, R12.2, R23.1, U6.11 (DAC2/A2C9/IO26)
D+: ESD.3 (I/O2), USB_IN.D+
D+_1: ESD.4 (I/O2_1), U5.5 (UD+)
D-: ESD.1 (I/O1), USB_IN.D-
D-_1: ESD.6 (I/O1_1), U5.6 (UD-)
DTR: Q2.1 (E), R21.1, U5.13 (!DTR)
EN: C11.1, Q2.3 (C), R9.2, R22.1, U6.3 (EN)
EN_BASE: Q2.5 (B), R21.2
FAULT1: R24.1, U6.7 (A1C7/IO35); also elsewhere on the board
FAULT2: R25.1, U6.6 (A1C6/IO34); also elsewhere on the board
GND: C3.2, C4.2, C5.2, C6.2, C7.2, C10.2, C11.2, C12.2, C15.2 (-), CELL4.NEG_C, CELL4.NEG_L, CELL4.NEG_R, CONFIG.2 (P1), CONFIG.SHLD@1 (SHIELD1), CONFIG.SHLD@2 (SHIELD2), DIAGNOSTIC.1, ESD.2 (GND), FLASH.1, I2C.1, POWER.2 (P1), R29.2, R30.2, R32.1, R33.1, RESET.1, U3.2 (GND), U4.2 (GND), U5.1 (GND), U6.1 (GND), U6.15 (GND), U6.38 (GND), U6.TP (GND), U6.TP1 (GND), U6.TP2 (GND), U6.TP3 (GND), U6.TP4 (GND), U6.TP5 (GND), U6.TP6 (GND), U6.TP7 (GND), U6.TP8 (GND), U6.TP9 (GND), USB_IN.GND, USB_IN.SHLD1 (SHIELD), USB_IN.SHLD2 (SHIELD), USB_IN.SHLD3 (SHIELD), USB_IN.SHLD4 (SHIELD), USB_IN.SHLD5 (SHIELD), USB_IN.SHLD6 (SHIELD), USB_IN.SHLD7 (SHIELD), USB_IN.SHLD8 (SHIELD); also elsewhere on the board
INPUT_PWR: D4.C, F1.1, Q1.3 (D)
IO0: Q2.6 (C), R13.2, R28.1, U6.25 (BL/A2C1/IO0)
IO0_BASE: Q2.2 (B), R20.2
LED1_B: R6.1, RGB1.3 (BLU)
LED1_G: R8.1, RGB1.2 (GRN)
LED1_R: R11.1, RGB1.1 (RED)
LED2_B: R5.1, RGB2.3 (BLU)
LED2_G: R7.1, RGB2.2 (GRN)
LED2_R: R10.1, RGB2.1 (RED)
unnamed: R31.2, U3.3 (EN)
unnamed: C3.1, U5.4 (V3)
unnamed: D5.3 (C), R34.1
unnamed: POWER.1 (S1), U4.1 (IN)
unnamed: D1.C, U4.6 (VCC)
unnamed: R9.1, RESET.2
unnamed: CELL1.NEG_C, CELL1.NEG_L, CELL1.NEG_R, CELL2.POS_C, CELL2.POS_L, CELL2.POS_R
unnamed: CELL2.NEG_C, CELL2.NEG_L, CELL2.NEG_R, CELL3.POS_C, CELL3.POS_L, CELL3.POS_R
unnamed: CELL3.NEG_C, CELL3.NEG_L, CELL3.NEG_R, CELL4.POS_C, CELL4.POS_L, CELL4.POS_R
unnamed: CONFIG.1 (S1), R12.1
unnamed: Q1.1 (G), R32.2, R34.2
unnamed: Q3.1 (G), R33.2, R35.2
unnamed: FLASH.2, R13.1
NC: U6.32 (NC)
NSLEEP: R30.1, U6.24 (HSWP/A2C2/IO2); also elsewhere on the board
RTS: Q2.4 (E), R20.1, U5.14 (!RTS)
RXD0: R15.2, U6.34 (RXD0/IO3)
SCL: I2C.3, R26.1, U6.36 (VSWP/IO22)
SDA: I2C.4, R27.1, U6.33 (VSHD/IO21)
SENSOR_VN: U6.5 (SVN/I039/A1C3)
SENSOR_VP: U6.4 (SVP/I036/A1C0)
SLED1_B: R6.2, U6.12 (A2C7/IO27)
SLED1_G: R8.2, U6.14 (HSDO/A2C5/IO12)
SLED1_R: R11.2, U6.13 (HSCK/A2C6/IO14)
SLED2_B: R5.2, U6.10 (DAC1/A2C8/IO25)
SLED2_G: R7.2, U6.9 (XOUT32K/A1C5/IO33)
SLED2_R: R10.2, U6.8 (XIN32K/A1C4/IO32)
TXD0: R14.1, U6.35 (TXD0/IO1)
USB_RXD: DIAGNOSTIC.4, R15.1, U5.2 (TXO)
USB_TXD: DIAGNOSTIC.5, Q3.3 (D), R14.2
USB_TXD_SW: Q3.2 (S), U5.3 (RXI)
V_BATT: D1.A, D3.C, Q1.2 (S)
V_USB: C4.1, D4.A, D5.1 (A1), DIAGNOSTIC.3, ESD.5 (VBUS), R35.1, U5.16 (VCC), USB_IN.VBUS

Notes on the sheet:
(Invert LED PWM output)
Reset Button
Config Button
RGB LED
Boot/Programming Control
Pin Headers
Mini-B Input
Flash Button
Do not use pins 17-22 connected to intergrated SPI flash chip
3V3 Reg
* Q3 prevents current leak through CH340 on TXD while running on batteries

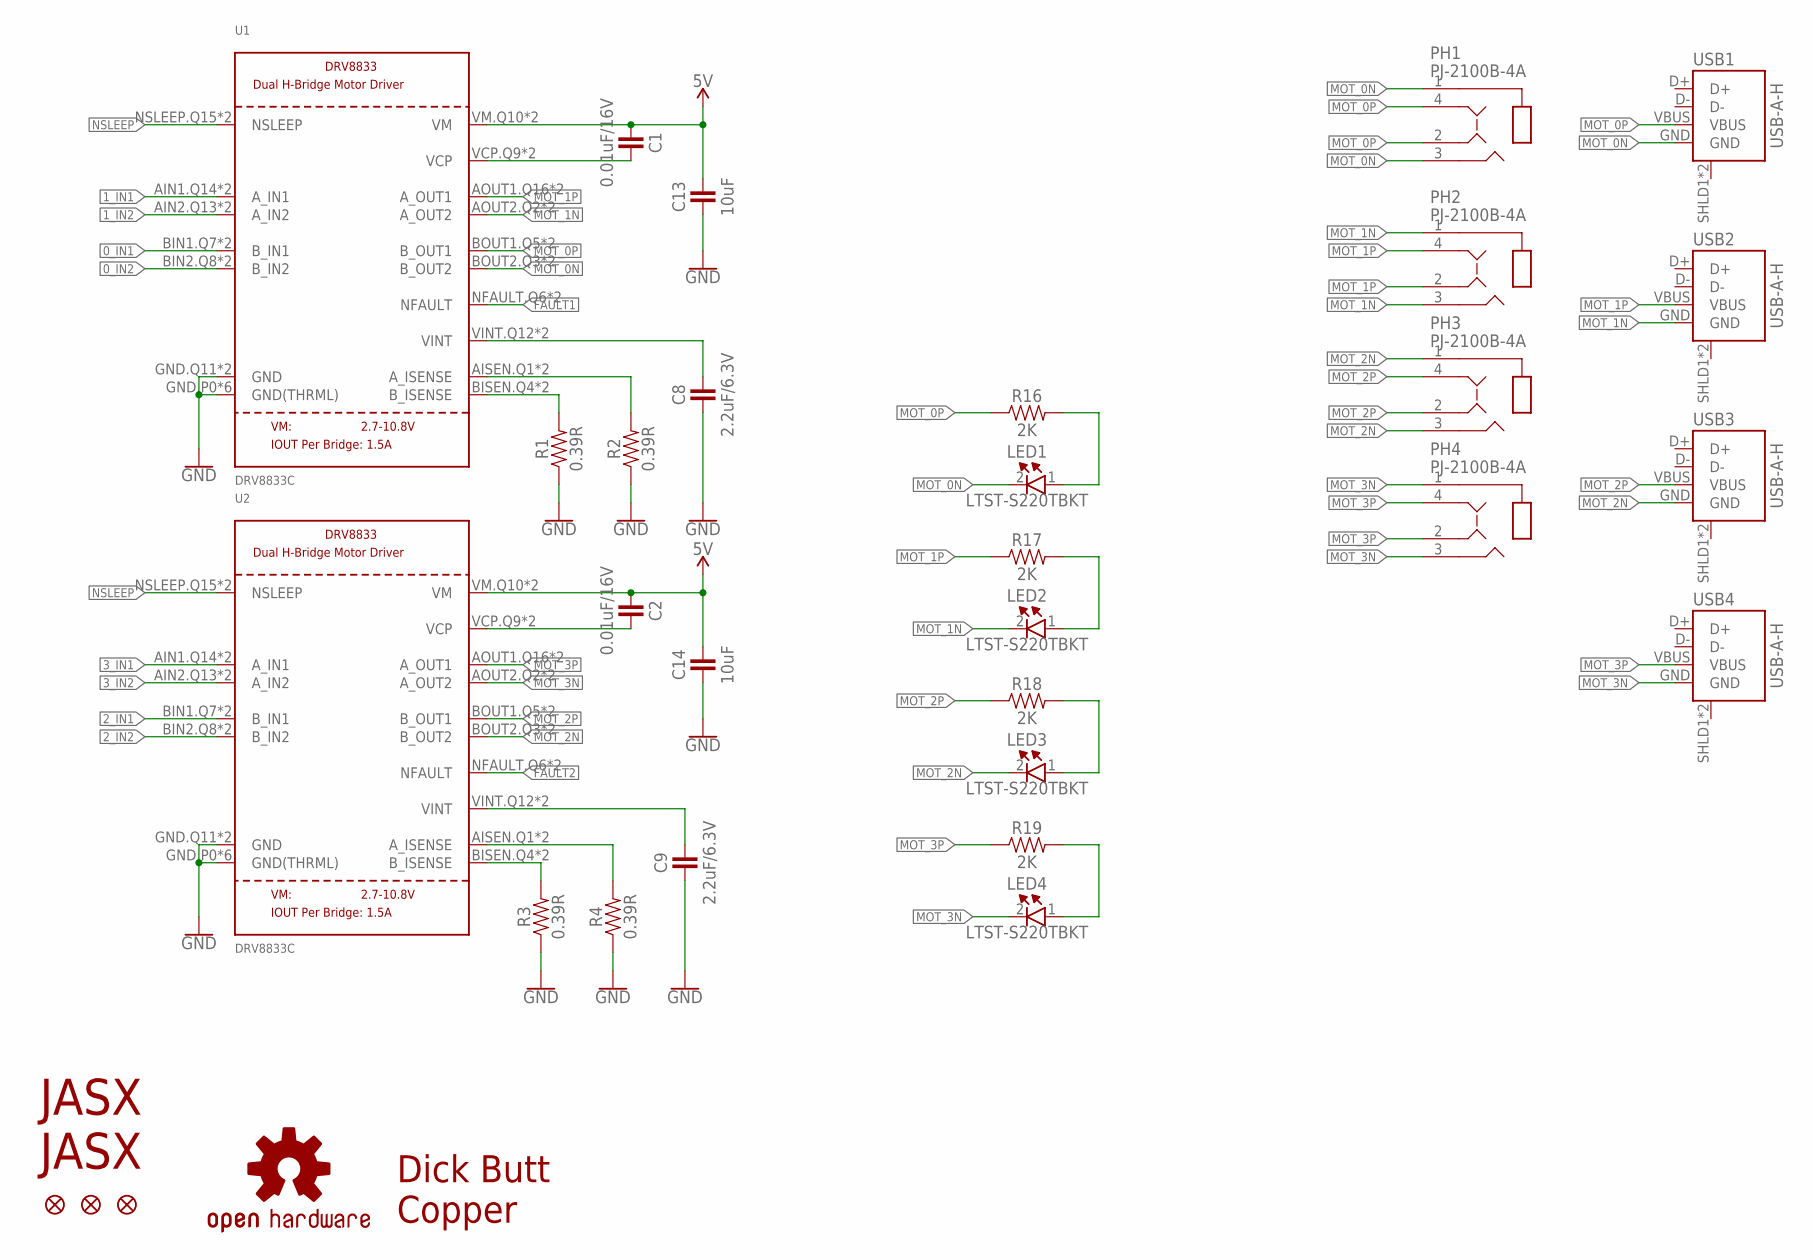
[picture p57: schematic vh_21c.sch, sheet 2]

Parts:
C1, C2: 0.01uF/16V; C0805
C8, C9: 2.2uF/6.3V; C0805
C13, C14: 10uF; C0805
FD1, FD2, FD3: FIDUCIAL1X2; FIDUCIAL-1X2
LED1, LED2, LED3, LED4: LTST-S220TBKT; LTST-S220KFKT
LOGO1: OSHW-LOGOM; OSHW-LOGO-M
LOGO2, LOGO4: JASX_LOGO_MID; JASX_LOGO_M
LOGO3: DICKBUTTCOPPER; DICKBUTT_COPPER
PH1, PH2, PH3, PH4: PJ-2100B-4A; PJ2100B4A
R1, R2, R3, R4: 0.39R; 0805
R16, R17, R18, R19: 2K; 0805
U1, U2: DRV8833C; DRV8833_COMBO
USB1, USB2, USB3, USB4: USB-A-H

Connections:
0_IN1: U1.BIN1.Q7 (B_IN1), U1.BIN1.T9 (B_IN1); also elsewhere on the board
0_IN2: U1.BIN2.Q8 (B_IN2), U1.BIN2.T10 (B_IN2); also elsewhere on the board
1_IN1: U1.AIN1.Q14 (A_IN1), U1.AIN1.T16 (A_IN1); also elsewhere on the board
1_IN2: U1.AIN2.Q13 (A_IN2), U1.AIN2.T15 (A_IN2); also elsewhere on the board
2_IN1: U2.BIN1.Q7 (B_IN1), U2.BIN1.T9 (B_IN1); also elsewhere on the board
2_IN2: U2.BIN2.Q8 (B_IN2), U2.BIN2.T10 (B_IN2); also elsewhere on the board
3_IN1: U2.AIN1.Q14 (A_IN1), U2.AIN1.T16 (A_IN1); also elsewhere on the board
3_IN2: U2.AIN2.Q13 (A_IN2), U2.AIN2.T15 (A_IN2); also elsewhere on the board
5V: C1.1, C2.1, C13.2, C14.2, U1.VM.Q10 (VM), U1.VM.T12 (VM), U2.VM.Q10 (VM), U2.VM.T12 (VM); also elsewhere on the board
A_ISENSE0: R2.2, U1.AISEN.Q1 (A_ISENSE), U1.AISEN.T3 (A_ISENSE)
A_ISENSE1: R4.2, U2.AISEN.Q1 (A_ISENSE), U2.AISEN.T3 (A_ISENSE)
B_ISENSE0: R1.2, U1.BISEN.Q4 (B_ISENSE), U1.BISEN.T6 (B_ISENSE)
B_ISENSE1: R3.2, U2.BISEN.Q4 (B_ISENSE), U2.BISEN.T6 (B_ISENSE)
FAULT1: U1.NFAULT.Q6 (NFAULT), U1.NFAULT.T8 (NFAULT); also elsewhere on the board
FAULT2: U2.NFAULT.Q6 (NFAULT), U2.NFAULT.T8 (NFAULT); also elsewhere on the board
GND: C8.1, C9.1, C13.1, C14.1, R1.1, R2.1, R3.1, R4.1, U1.GND.P0 (GND(THRML)), U1.GND.P1 (GND(THRML)), U1.GND.P2 (GND(THRML)), U1.GND.P3 (GND(THRML)), U1.GND.P4 (GND(THRML)), U1.GND.P5 (GND(THRML)), U1.GND.Q11 (GND), U1.GND.T13 (GND), U2.GND.P0 (GND(THRML)), U2.GND.P1 (GND(THRML)), U2.GND.P2 (GND(THRML)), U2.GND.P3 (GND(THRML)), U2.GND.P4 (GND(THRML)), U2.GND.P5 (GND(THRML)), U2.GND.Q11 (GND), U2.GND.T13 (GND); also elsewhere on the board
MOT_0N: LED1.2 (K), PH1.1, PH1.3, U1.BOUT2.Q3 (B_OUT2), U1.BOUT2.T5 (B_OUT2), USB1.GND
MOT_0P: PH1.2, PH1.4, R16.1, U1.BOUT1.Q5 (B_OUT1), U1.BOUT1.T7 (B_OUT1), USB1.VBUS
MOT_1N: LED2.2 (K), PH2.1, PH2.3, U1.AOUT2.Q2 (A_OUT2), U1.AOUT2.T4 (A_OUT2), USB2.GND
MOT_1P: PH2.2, PH2.4, R17.1, U1.AOUT1.Q16 (A_OUT1), U1.AOUT1.T2 (A_OUT1), USB2.VBUS
MOT_2N: LED3.2 (K), PH3.1, PH3.3, U2.BOUT2.Q3 (B_OUT2), U2.BOUT2.T5 (B_OUT2), USB3.GND
MOT_2P: PH3.2, PH3.4, R18.1, U2.BOUT1.Q5 (B_OUT1), U2.BOUT1.T7 (B_OUT1), USB3.VBUS
MOT_3N: LED4.2 (K), PH4.1, PH4.3, U2.AOUT2.Q2 (A_OUT2), U2.AOUT2.T4 (A_OUT2), USB4.GND
MOT_3P: PH4.2, PH4.4, R19.1, U2.AOUT1.Q16 (A_OUT1), U2.AOUT1.T2 (A_OUT1), USB4.VBUS
unnamed: LED1.1 (A), R16.2
unnamed: LED2.1 (A), R17.2
unnamed: LED3.1 (A), R18.2
unnamed: LED4.1 (A), R19.2
NSLEEP: U1.NSLEEP.Q15 (NSLEEP), U1.NSLEEP.T1 (NSLEEP), U2.NSLEEP.Q15 (NSLEEP), U2.NSLEEP.T1 (NSLEEP); also elsewhere on the board
VCP0: C1.2, U1.VCP.Q9 (VCP), U1.VCP.T11 (VCP)
VCP1: C2.2, U2.VCP.Q9 (VCP), U2.VCP.T11 (VCP)
VINT0: C8.2, U1.VINT.Q12 (VINT), U1.VINT.T14 (VINT)
VINT1: C9.2, U2.VINT.Q12 (VINT), U2.VINT.T14 (VINT)

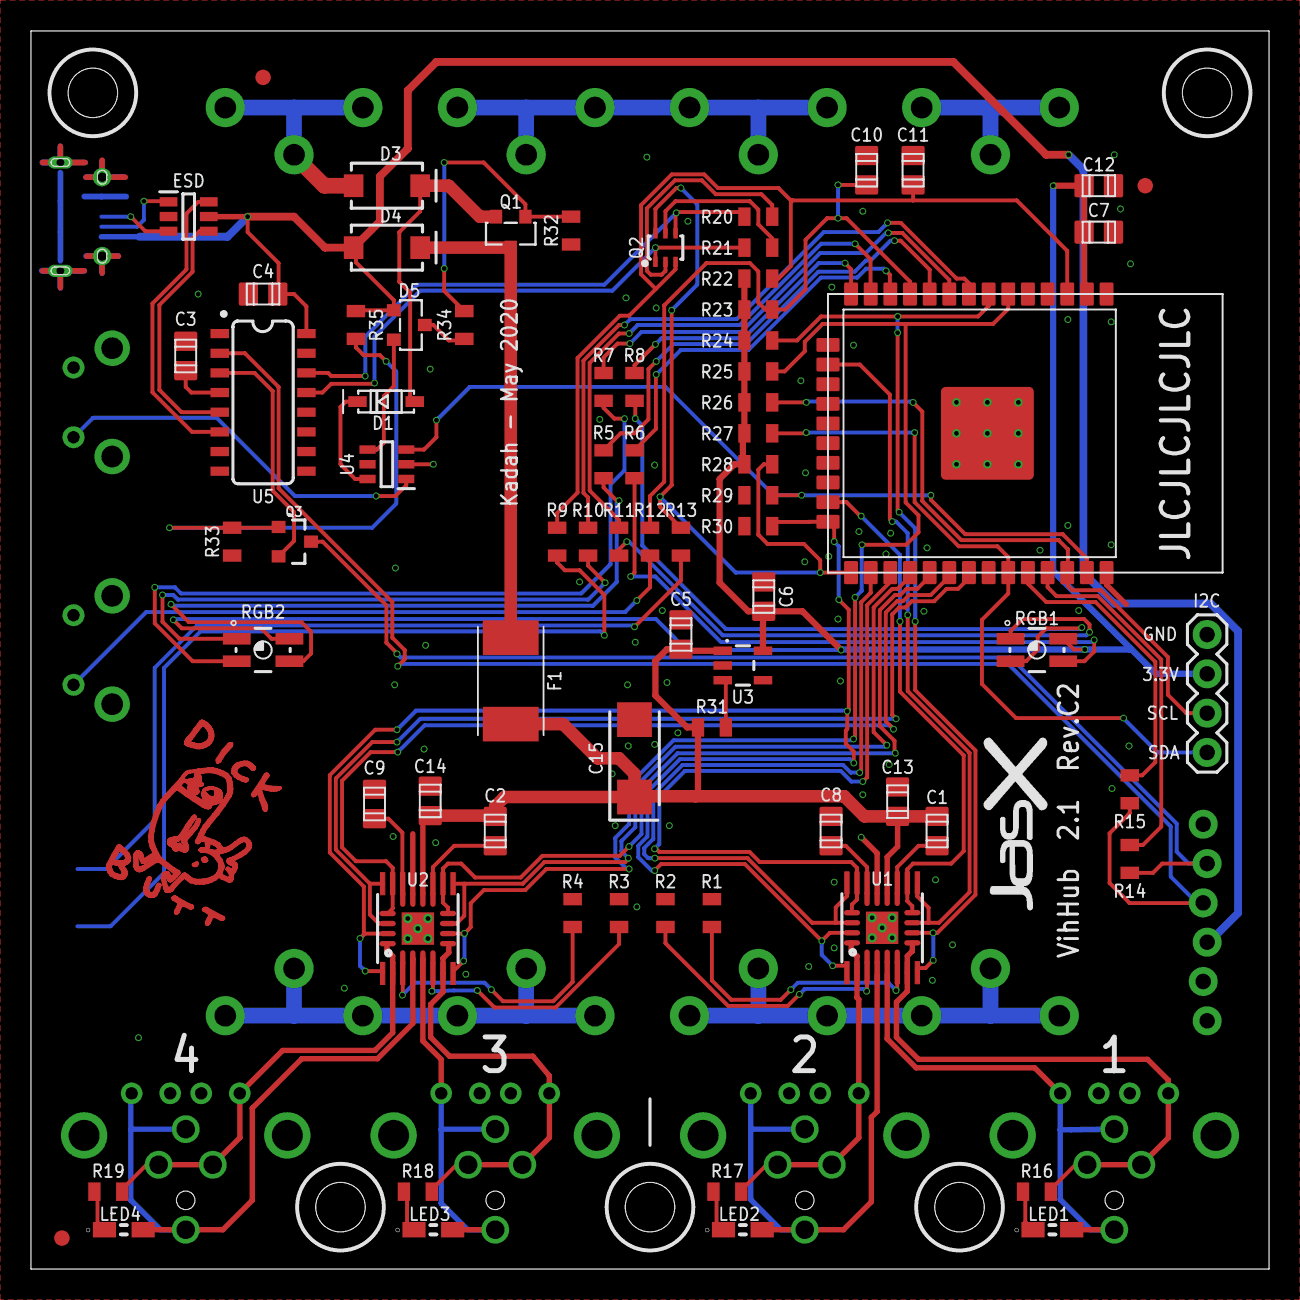
[picture p58: board vh_21c.brd from above]

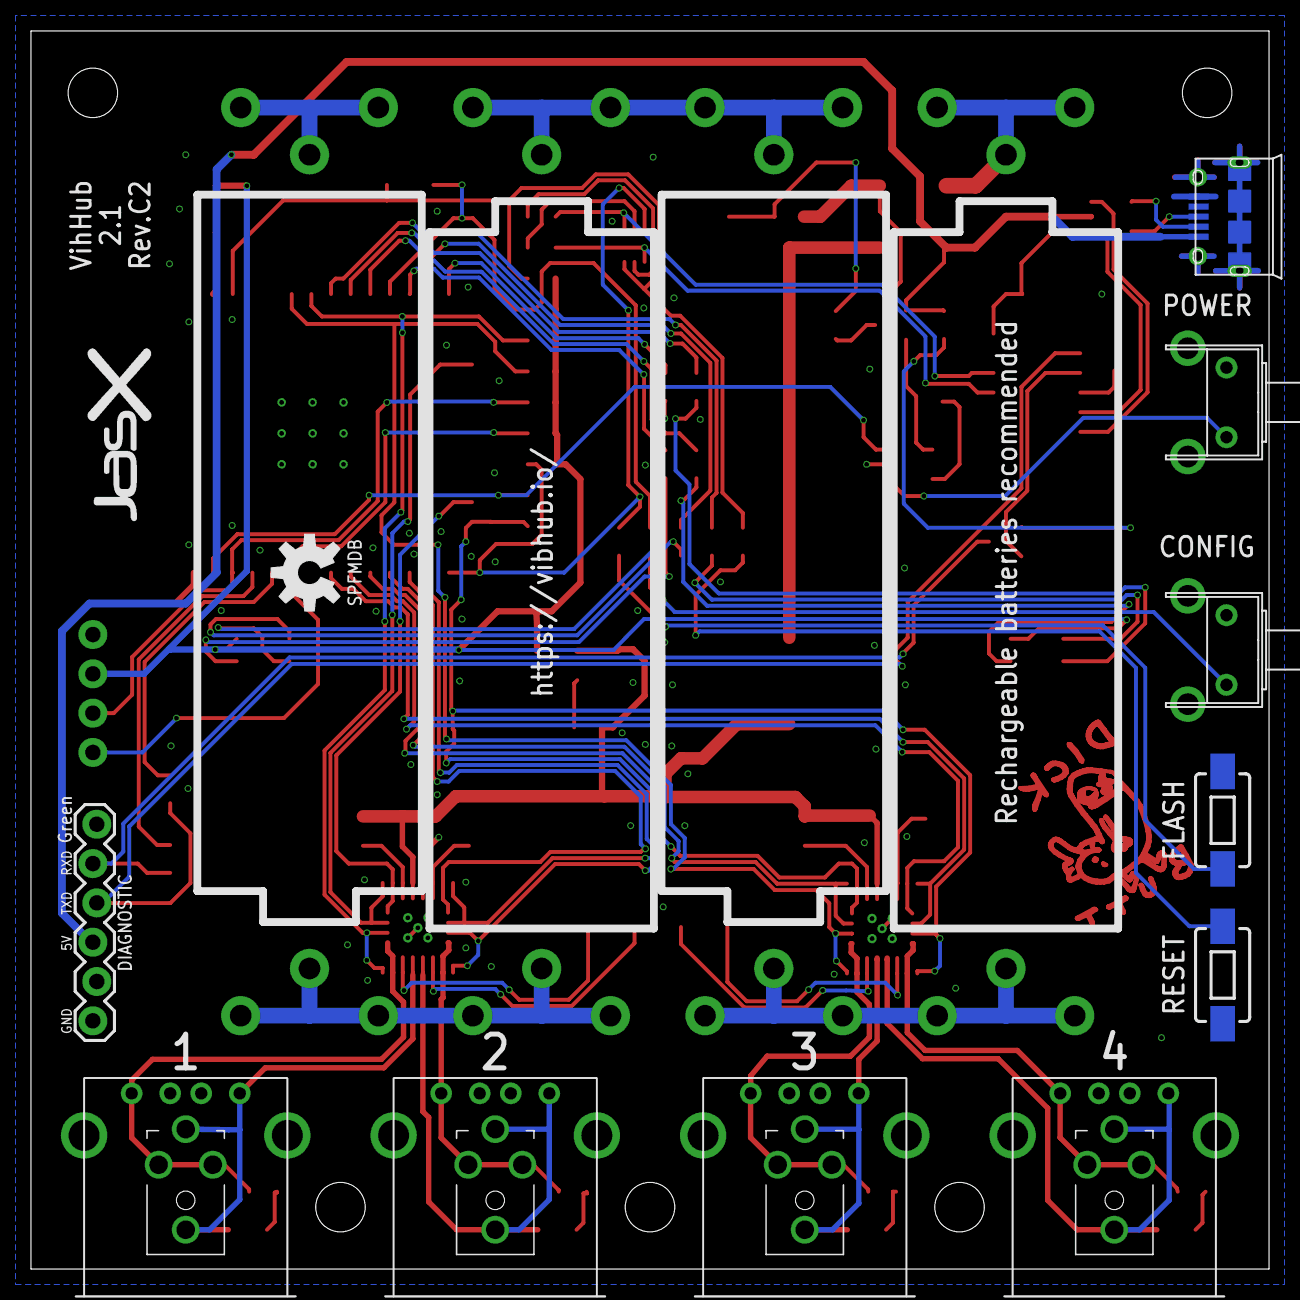
[picture p59: board vh_21c.brd from below]

Board: 2 copper layers, 80.0 x 80.0 mm, 97 parts (20 on the bottom side), 83 nets.
