JasXSL/VibHub-ESP32/VibHub32_1.0/2.0a/esp32board.brd

## EAGLE design VibHub32_1.0/2.0a/esp32board.brd (2018-10-22)

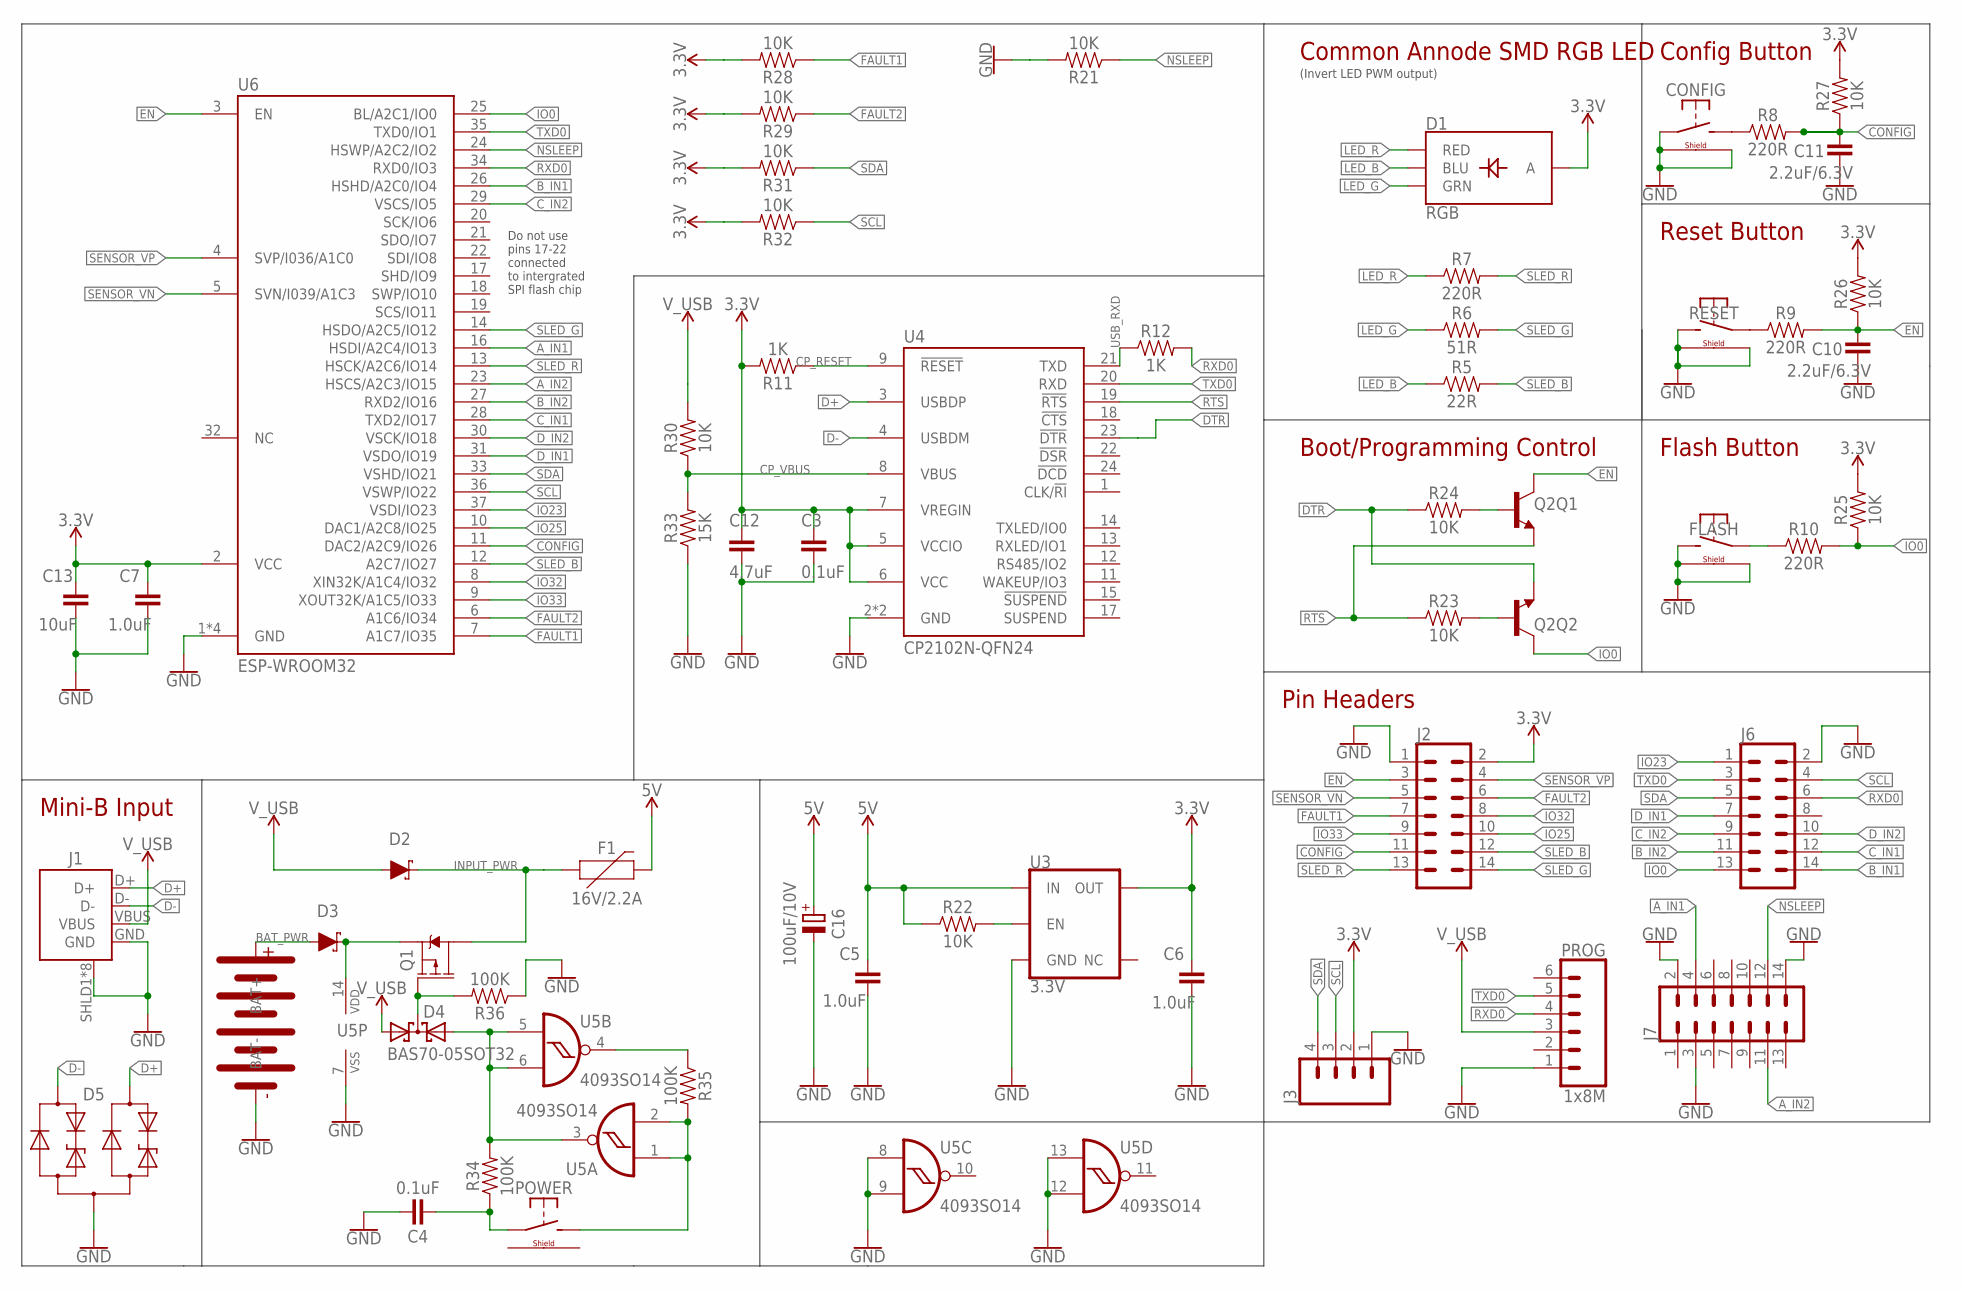
[picture p60: schematic esp32board.sch, sheet 1]

Parts:
BAT: BC4AAPCBC4AAPC; BC4AAPC
C3, C4: 0.1uF; C0805
C5, C6, C7: 1.0uF; C0805
C10, C11: 2.2uF/6.3V; C0805
C12: 4.7uF; C0805
C13: 10uF; C0805
C16: 100uF/10V; PANASONIC_D
CONFIG: MOMENTARY-SWITCH-SPST-RIGHTSQ75; SW6X6_RIGHT_SQ73
D1: RGB; P-LCC-4-3
D2, D3: 3A/40V/500mV; SMA-DIODE
D4: BAS70-05SOT32; SOT91P240X110-3
D5: D_ESD5V3U2U-03F; SOT723
F1: 16V/2.2A; FUSC7035X90
FLASH: MOMENTARY-SWITCH-SPST-RIGHTSQ75; SW6X6_RIGHT_SQ73
J1: USB-MICROB-2; USB-MICROB-10118194
J2, J6, J7: CONN_07X2; 2X7
J3: CONN_04; 1X04
POWER: MOMENTARY-SWITCH-SPST-RIGHTSQ75; SW6X6_RIGHT_SQ73
PROG: 1x8M; 1X06_LOCK
Q1: MOSFET_PCH-DMG2305UX-13; SOT91P240X110-3
Q2: TRANS_NPN_DUAL-MBT3904DW1T1; SC70-6
R5: 22R; 0805
R6: 51R; 0805
R7, R8, R9, R10: 220R; 0805
R11, R12: 1K; 0805
R21, R22, R23, R24, R25, R26, R27, R28, R29, R30, R31, R32: 10K; 0805
R33: 15K; 0805
R34, R35, R36: 100K; 0805
RESET: MOMENTARY-SWITCH-SPST-RIGHTSQ75; SW6X6_RIGHT_SQ73
U3: 3.3V; SOT23-5
U4: CP2102N-QFN24; QFN24-PAD
U5: 4093SO14; SOIC127P600X175-14
U6: ESP-WROOM32

Connections:
3.3V: C3.1, C6.1, C7.1, C12.1, C13.1, D1.4 (A), J2.2, J3.2, R11.2, R25.2, R26.2, R27.2, R28.2, R29.2, R31.2, R32.2, U3.5 (OUT), U4.5 (VCCIO), U4.6 (VCC), U4.7 (VREGIN), U6.2 (VCC)
5V: C5.1, C16.+, F1.2, R22.1, U3.1 (IN); also elsewhere on the board
A_IN1: J7.4, U6.16 (HSDI/A2C4/IO13); also elsewhere on the board
A_IN2: J7.11, U6.23 (HSCS/A2C3/IO15); also elsewhere on the board
BAT_PWR: BAT.P$1 (BAT+), D3.A
B_IN1: J6.14, U6.26 (HSHD/A2C0/IO4); also elsewhere on the board
B_IN2: J6.11, U6.27 (RXD2/IO16); also elsewhere on the board
CONFIG: C11.1, J2.11, R8.2, R27.1, U6.11 (DAC2/A2C9/IO26)
CP_RESET: R11.1, U4.9 (!RESET)
CP_VBUS: R30.1, R33.2, U4.8 (VBUS)
C_IN1: J6.12, U6.28 (TXD2/IO17); also elsewhere on the board
C_IN2: J6.9, U6.29 (VSCS/IO5); also elsewhere on the board
D+: D5.2 (C2), J1.D+, U4.3 (USBDP)
D-: D5.1 (C1), J1.D-, U4.4 (USBDM)
DTR: Q2.1 (E), R24.1, U4.23 (!DTR)
D_IN1: J6.7, U6.31 (VSDO/IO19); also elsewhere on the board
D_IN2: J6.10, U6.30 (VSCK/IO18); also elsewhere on the board
EN: C10.1, J2.3, Q2.3 (C), R9.2, R26.1, U6.3 (EN)
EN_BASE: Q2.5 (B), R24.2
FAULT1: J2.7, R28.1, U6.7 (A1C7/IO35); also elsewhere on the board
FAULT2: J2.6, R29.1, U6.6 (A1C6/IO34); also elsewhere on the board
GND: BAT.P$2 (BAT-), C3.2, C4.2, C5.2, C6.2, C7.2, C10.2, C11.2, C12.2, C13.2, C16.-, CONFIG.2 (P1), CONFIG.SHLD@1 (SHIELD1), CONFIG.SHLD@2 (SHIELD2), D5.3 (A), FLASH.1 (S1), FLASH.SHLD@1 (SHIELD1), FLASH.SHLD@2 (SHIELD2), J1.GND, J1.SHLD1 (SHIELD), J1.SHLD2 (SHIELD), J1.SHLD3 (SHIELD), J1.SHLD4 (SHIELD), J1.SHLD5 (SHIELD), J1.SHLD6 (SHIELD), J1.SHLD7 (SHIELD), J1.SHLD8 (SHIELD), J2.1, J3.1, J6.2, J7.2, J7.3, J7.14, PROG.1, R21.2, R33.1, R36.1, RESET.1 (S1), RESET.SHLD@1 (SHIELD1), RESET.SHLD@2 (SHIELD2), U3.2 (GND), U4.2 (GND), U4.TP (GND), U5.7 (VSS), U5.8 (I0), U5.9 (I1), U5.12 (I1), U5.13 (I0), U6.1 (GND), U6.15 (GND), U6.38 (GND), U6.TP (GND); also elsewhere on the board
INPUT_PWR: D2.C, F1.1, Q1.3 (D)
IO0: J6.13, Q2.6 (C), R10.2, R25.1, U6.25 (BL/A2C1/IO0)
IO0_BASE: Q2.2 (B), R23.2
IO23: J6.1, U6.37 (VSDI/IO23)
IO25: J2.10, U6.10 (DAC1/A2C8/IO25)
IO32: J2.8, U6.8 (XIN32K/A1C4/IO32)
IO33: J2.9, U6.9 (XOUT32K/A1C5/IO33)
LED_B: D1.3 (BLU), R5.1
LED_G: D1.2 (GRN), R6.1
LED_R: D1.1 (RED), R7.1
unnamed: R22.2, U3.3 (EN)
unnamed: D3.C, Q1.2 (S), U5.14 (VDD)
unnamed: POWER.1 (S1), R35.2, U5.1 (I0), U5.2 (I1)
unnamed: CONFIG.1 (S1), R8.1
unnamed: D4.2 (A2), R34.2, U5.3 (O), U5.5 (I0), U5.6 (I1)
unnamed: D4.3 (C), Q1.1 (G), R36.2
unnamed: R35.1, U5.4 (O)
unnamed: C4.1, POWER.2 (P1), R34.1
unnamed: FLASH.2 (P1), R10.1
unnamed: R9.1, RESET.2 (P1)
NSLEEP: J7.12, R21.1, U6.24 (HSWP/A2C2/IO2); also elsewhere on the board
RTS: Q2.4 (E), R23.1, U4.19 (!RTS)
RXD0: J6.6, PROG.4, R12.2, U6.34 (RXD0/IO3)
SCL: J3.3, J6.4, R32.1, U6.36 (VSWP/IO22)
SDA: J3.4, J6.5, R31.1, U6.33 (VSHD/IO21)
SENSOR_VN: J2.5, U6.5 (SVN/I039/A1C3)
SENSOR_VP: J2.4, U6.4 (SVP/I036/A1C0)
SLED_B: J2.12, R5.2, U6.12 (A2C7/IO27)
SLED_G: J2.14, R6.2, U6.14 (HSDO/A2C5/IO12)
SLED_R: J2.13, R7.2, U6.13 (HSCK/A2C6/IO14)
TXD0: J6.3, PROG.5, U4.20 (RXD), U6.35 (TXD0/IO1)
USB_RXD: R12.1, U4.21 (TXD)
V_USB: D2.A, D4.1 (A1), J1.VBUS, PROG.3, R30.2

Notes on the sheet:
(Invert LED PWM output)
Reset Button
Config Button
Common Annode SMD RGB LED
Boot/Programming Control
Pin Headers
Mini-B Input
Flash Button
Do not use pins 17-22 connected to intergrated SPI flash chip

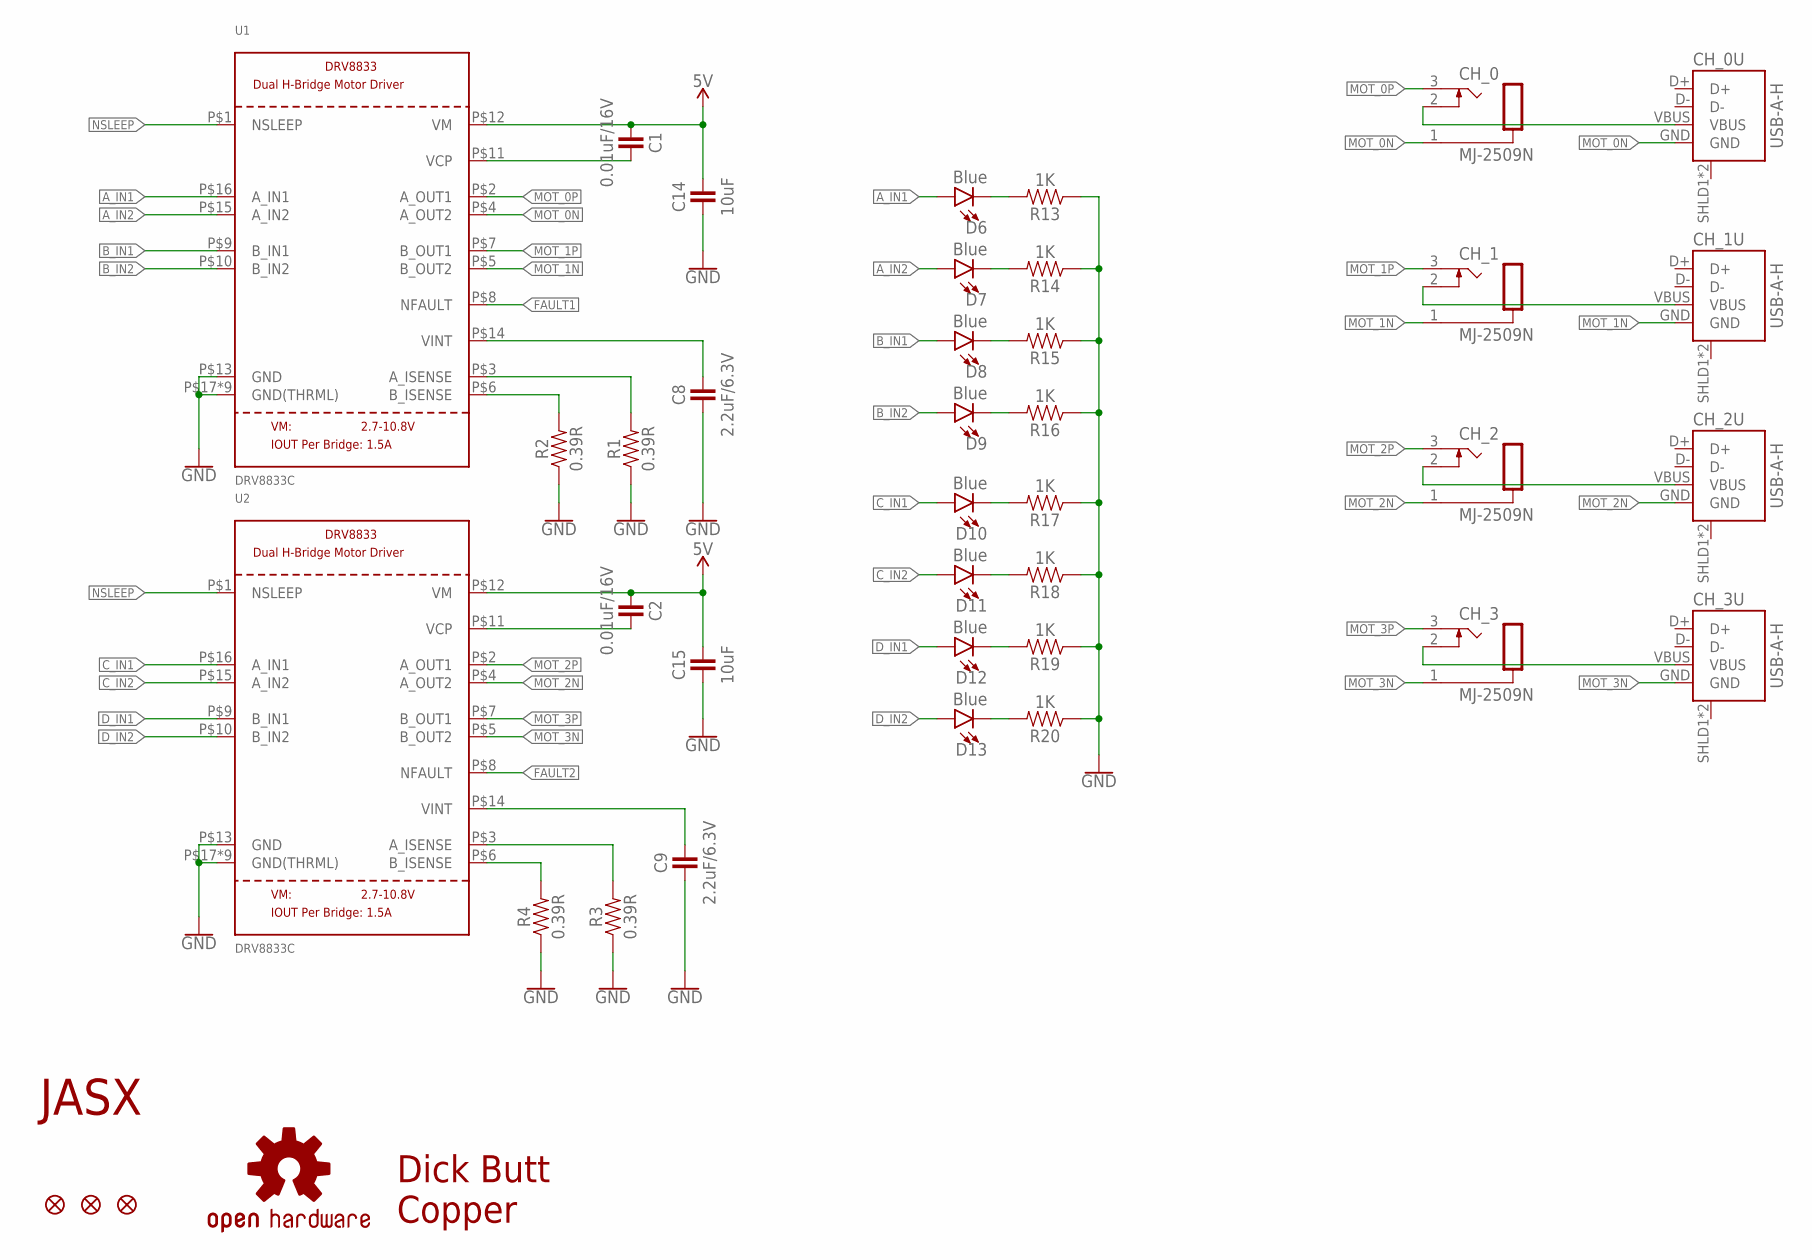
[picture p61: schematic esp32board.sch, sheet 2]

Parts:
C1, C2: 0.01uF/16V; C0805
C8, C9: 2.2uF/6.3V; C0805
C14, C15: 10uF; C0805
CH_0, CH_1, CH_2, CH_3: MJ-2509N
CH_0U, CH_1U, CH_2U, CH_3U: USB-A-H
D6, D7, D8, D9, D10, D11, D12, D13: Blue; CHIPLED_0805
FD1, FD2, FD3: FIDUCIAL1X2; FIDUCIAL-1X2
LOGO1: OSHW-LOGOM; OSHW-LOGO-M
LOGO2: JASX_LOGO_MID; JASX_LOGO_M
LOGO3: DICKBUTTCOPPER; DICKBUTT_COPPER
R1, R2, R3, R4: 0.39R; 0805
R13, R14, R15, R16, R17, R18, R19, R20: 1K; 0805
U1, U2: DRV8833C; HTSSOP16

Connections:
5V: C1.1, C2.1, C14.2, C15.2, U1.P$12 (VM), U2.P$12 (VM); also elsewhere on the board
A_IN1: D6.A, U1.P$16 (A_IN1); also elsewhere on the board
A_IN2: D7.A, U1.P$15 (A_IN2); also elsewhere on the board
A_ISENSE0: R1.2, U1.P$3 (A_ISENSE)
A_ISENSE1: R3.2, U2.P$3 (A_ISENSE)
B_IN1: D8.A, U1.P$9 (B_IN1); also elsewhere on the board
B_IN2: D9.A, U1.P$10 (B_IN2); also elsewhere on the board
B_ISENSE0: R2.2, U1.P$6 (B_ISENSE)
B_ISENSE1: R4.2, U2.P$6 (B_ISENSE)
C_IN1: D10.A, U2.P$16 (A_IN1); also elsewhere on the board
C_IN2: D11.A, U2.P$15 (A_IN2); also elsewhere on the board
D_IN1: D12.A, U2.P$9 (B_IN1); also elsewhere on the board
D_IN2: D13.A, U2.P$10 (B_IN2); also elsewhere on the board
FAULT1: U1.P$8 (NFAULT); also elsewhere on the board
FAULT2: U2.P$8 (NFAULT); also elsewhere on the board
GND: C8.1, C9.1, C14.1, C15.1, R1.1, R2.1, R3.1, R4.1, R13.1, R14.1, R15.1, R16.1, R17.1, R18.1, R19.1, R20.1, U1.P$13 (GND), U1.P$17 (GND(THRML)), U1.P$18 (GND(THRML)), U1.P$19 (GND(THRML)), U1.P$20 (GND(THRML)), U1.P$21 (GND(THRML)), U1.P$22 (GND(THRML)), U1.P$23 (GND(THRML)), U1.P$24 (GND(THRML)), U1.P$25 (GND(THRML)), U2.P$13 (GND), U2.P$17 (GND(THRML)), U2.P$18 (GND(THRML)), U2.P$19 (GND(THRML)), U2.P$20 (GND(THRML)), U2.P$21 (GND(THRML)), U2.P$22 (GND(THRML)), U2.P$23 (GND(THRML)), U2.P$24 (GND(THRML)), U2.P$25 (GND(THRML)); also elsewhere on the board
MOT_0N: CH_0.1 (S), CH_0U.GND, U1.P$4 (A_OUT2)
MOT_0P: CH_0.3 (T), U1.P$2 (A_OUT1)
MOT_1N: CH_1.1 (S), CH_1U.GND, U1.P$5 (B_OUT2)
MOT_1P: CH_1.3 (T), U1.P$7 (B_OUT1)
MOT_2N: CH_2.1 (S), CH_2U.GND, U2.P$4 (A_OUT2)
MOT_2P: CH_2.3 (T), U2.P$2 (A_OUT1)
MOT_3N: CH_3.1 (S), CH_3U.GND, U2.P$5 (B_OUT2)
MOT_3P: CH_3.3 (T), U2.P$7 (B_OUT1)
unnamed: D6.C, R13.2
unnamed: D7.C, R14.2
unnamed: D8.C, R15.2
unnamed: D9.C, R16.2
unnamed: D10.C, R17.2
unnamed: D11.C, R18.2
unnamed: D12.C, R19.2
unnamed: D13.C, R20.2
unnamed: CH_3.2 (TS), CH_3U.VBUS
unnamed: CH_0.2 (TS), CH_0U.VBUS
unnamed: CH_1.2 (TS), CH_1U.VBUS
unnamed: CH_2.2 (TS), CH_2U.VBUS
NSLEEP: U1.P$1 (NSLEEP), U2.P$1 (NSLEEP); also elsewhere on the board
VCP0: C1.2, U1.P$11 (VCP)
VCP1: C2.2, U2.P$11 (VCP)
VINT0: C8.2, U1.P$14 (VINT)
VINT1: C9.2, U2.P$14 (VINT)
