JasXSL/VibHub-ESP32/VibHub32_1.0/2.0a/esp32board.brd

## EAGLE design VibHub32_1.0/2.0a/esp32board.brd (continued)

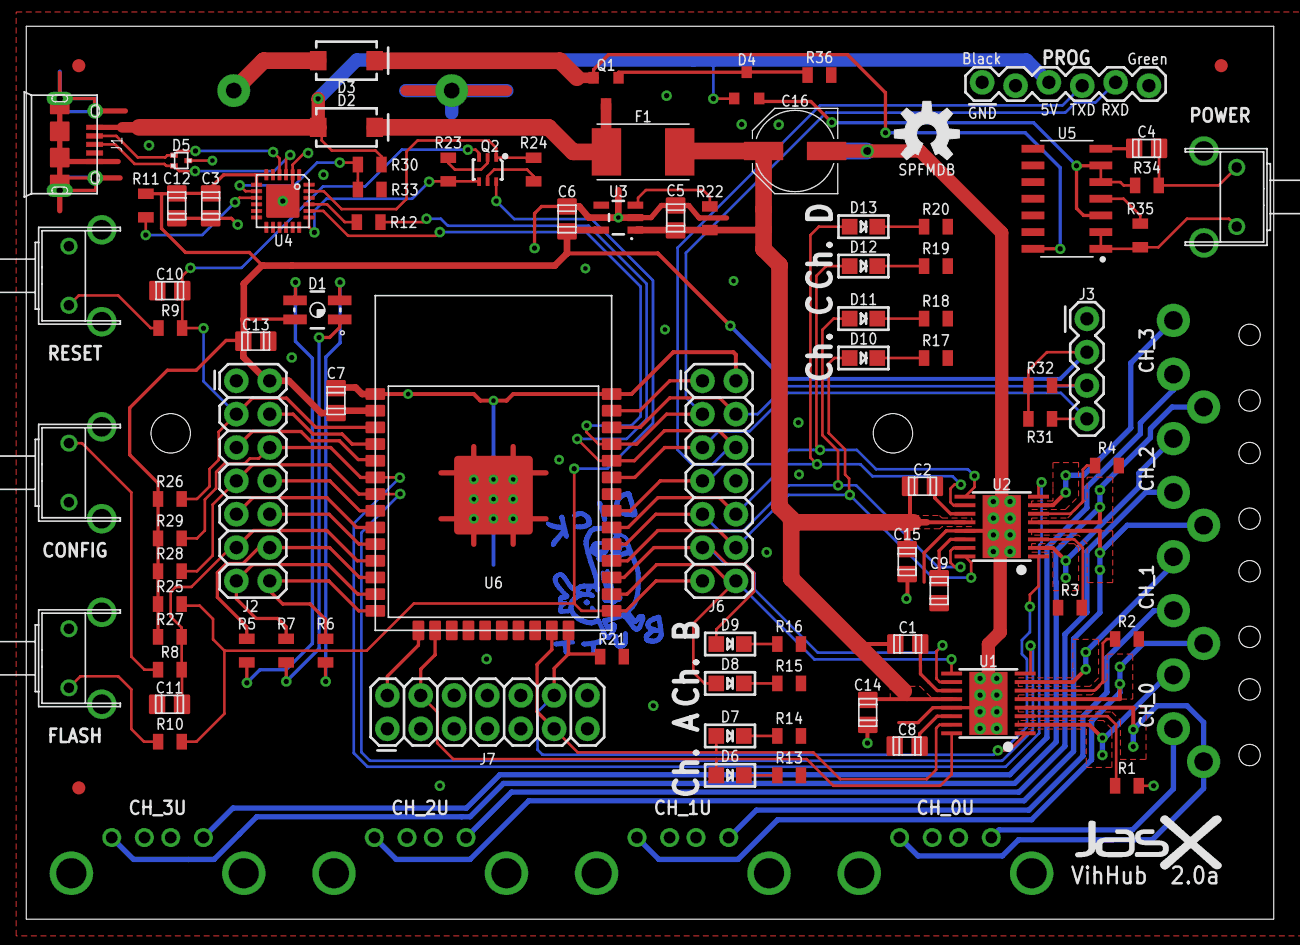
[picture p62: board esp32board.brd from above]

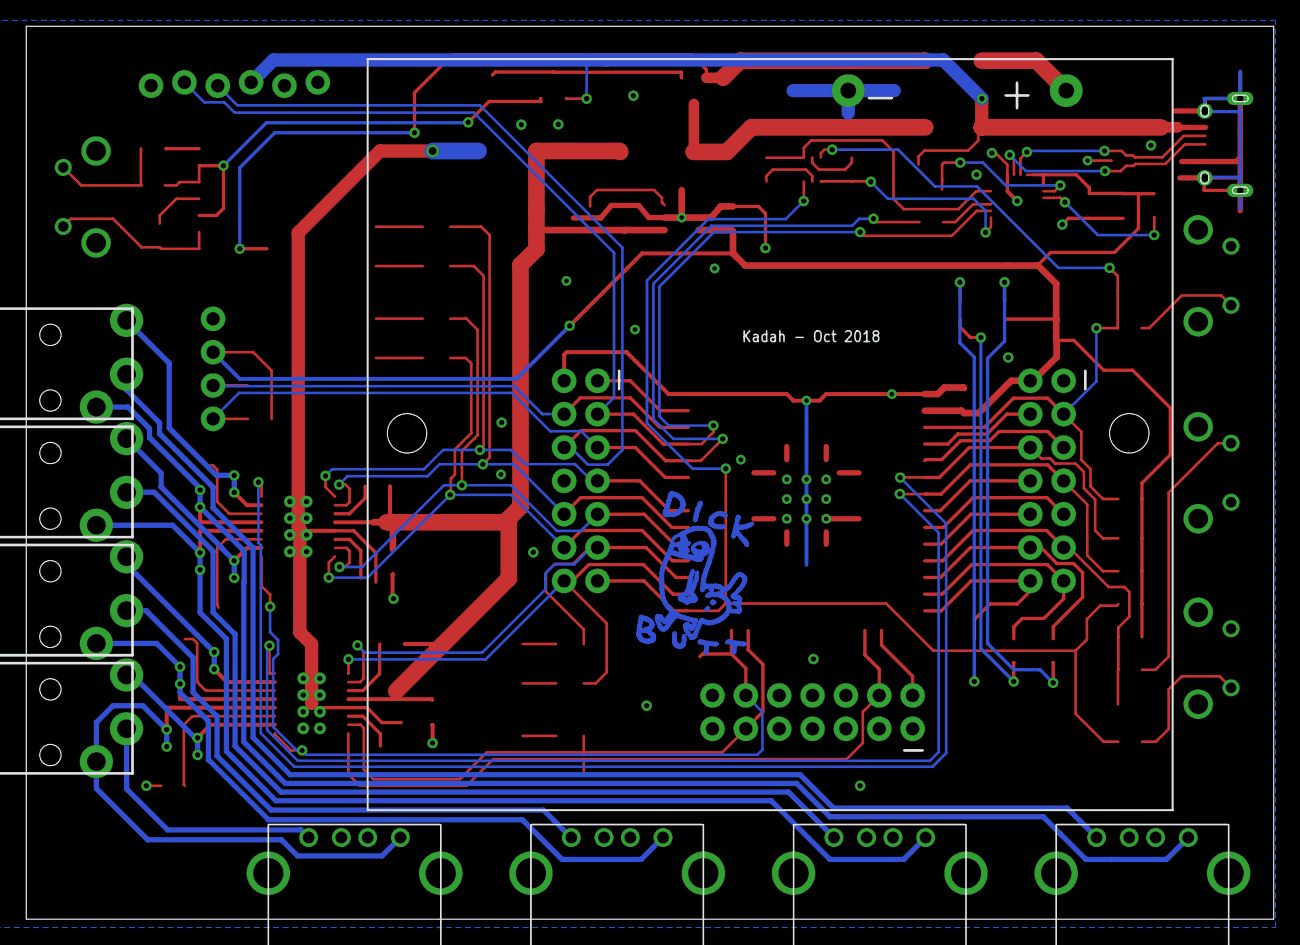
[picture p63: board esp32board.brd from below]

Board: 2 copper layers, 95.0 x 68.0 mm, 99 parts (10 on the bottom side), 83 nets.
