JasXSL/VibHub-ESP32/Firmware/VibHub-ESP32/StatusLED.h

/*
    VibHub Led
*/
#ifndef StatusLED_h
#define StatusLED_h

#include <Arduino.h>
#include "Pwm.h"
#include <functional>
using namespace std::placeholders;
class StatusLED{

    public:
        StatusLED(void);
        void initialize();  // Reserves PWM channels
        static const uint8_t STATE_BOOT;
        static const uint8_t STATE_INIT;
        static const uint8_t STATE_PORTAL;
        static const uint8_t STATE_WIFI_ERR;
        static const uint8_t STATE_SOCKET_ERR;
        static const uint8_t STATE_RUNNING;
        
        bool ledTickerHigh;
        void setState( int state = STATE_BOOT );
        void setLed( uint8_t color  );
        void setLedColor( uint8_t led, uint16_t r, uint16_t g, uint16_t b );

        void test();
        static void testTick( int color );
        static void flashingTick( int color );
        
        
    private:
        int programState;           // State the program is currently in

        Pwm p_red;
        Pwm p_green;
        Pwm p_blue;

        Pwm p2_red;
        Pwm p2_green;
        Pwm p2_blue;
        
        uint8_t testColor;

};


extern StatusLED statusLED;

#endif //StatusLED_h
