JasXSL/VibHub-ESP32/(commit log)

2018-08-23 Initial commit
    Motor driver is still missing. Can't get portal to work either.
    [Configuration.h]
2018-08-23 Fix for RGB LED
    [Configuration.h]
2018-08-24 Adds motor stuff. Instant sets work, but programs crash the ESP at line 89 of Motor.cpp
    [Configuration.h]
2018-08-25 ITWERKS - Mapped up the rest of the motors - The whole thing at least runs now. Time for improvements
    [Configuration.h]
2018-08-25 - Add hardware RNG. - Add wifi error handler
    [Configuration.h]
2018-08-25 Re-implemented DRV8833 features Renamed pin and pwm variables to match DRV8833's input names Added details from data sheet about decay modes
2018-08-25 Added output enable/disable back to ApiClient
    [Configuration.h]
2018-08-26 Added initial OTA support (see comments #2) Renamed pin defines for motors to match driver input names
    [Configuration.h]
2018-08-28 Tweening 2 test added
    [Configuration.h]
2018-08-29 Unit tests - Program resets added so you can keep one program object per motor - Added missing easing types
    [TweenProgram.cpp, TweenProgram.h, TweenProgramStage.cpp, tween.ino]
2018-08-29 Implement the new tweening
    [Configuration.h]
2018-08-29 Set tween program to completed at initialization to prevent PWM updates while nothing is running
    [Motor.cpp, TweenProgram.cpp]
2018-10-22 Added 1.0 board and config
    [BOM.ods, Configuration.h, esp32board.brd, esp32board.sch]
2018-10-22 Updated comments on config
    [Configuration.h]
2018-10-23 Added board test sketch
    [Configuration.h]
2019-01-17 Make bluetooth pairing toggleable by holding the config button
    [Configuration.h]
2019-02-02 Only force reboot if BT was just enabled when saving settings.
    [VhWifi.cpp]
2019-02-02 fix bluetooth config flash
    [ConfigButton.cpp, StatusLED.cpp]
2019-07-22 Added case STLs
    [Buttons.stl, Case Bottom.stl, Case Top - Logo.stl, Case Top - No Vents.stl, Case Top.stl, Port Jig.stl]
2019-07-22 Added experimental v0.2.1 firmware
    [Configuration.h]
2019-07-22 Upgrade to ArduinoJSON6
2019-07-24 Fix for clicking the WHOLE button. That's 60% more button per button!
    [Motor.cpp, VhWifi.h]
2019-07-28 Added SSL support
    [Configuration.h]
2019-08-01 Catch crash on bad program
    [TweenProgram.cpp]
2019-08-01 Wait for longer for WiFi Update to connect to official VibHub SSL default
    [Configuration.h]
2019-08-02 Removed old test code
    [Configuration.h]
2019-08-04 Forked socket.io-client library Updated library links comment
2019-08-04 Moved sketch to sub folder
    [Configuration.h]
2019-08-04 Moved board test sketch
    [Configuration.h]
2019-08-07 Moved 2.0a board files to subfolder
    [BOM.ods, Buttons.stl, Case Bottom.stl, Case Top - Logo.stl, Case Top - No Vents.stl, Case Top.stl, Port Jig.stl, esp32board.brd]
2019-09-14 Remove bluetooth
    [Configuration.h]
2019-10-23 Lower PWM freq and reverse port order
    [Configuration.h]
2019-10-23 LEDC didn't like low freq :< set it to 5khz
    [Configuration.h]
2019-12-24 Added second LED and updates for 2.1 board
    [Configuration.h]
2019-12-24 Updated board tester sketch
    [Configuration.h]
2019-12-27 Added hardware info printouts to test sketch
2020-01-12 Fixed unable to set PWM duty cycle to 100% (256)
    [Configuration.h]
2020-03-05 Added files for 2.1c board rev Added board test for 2.1b+ Update format sketch
    [BOM.ods, Configuration.h, Mini BOM.ods, vh_21c.brd, vh_21c.sch]
2020-03-05 Missing changes from last commit
    [BOM.ods, Mini BOM.ods, vh_21c.brd]
2020-03-06 BOM consolidation Removed 150K 0805 res requirement
    [BOM.ods, Mini BOM.ods, vh_21c.brd]
2020-03-06 Unsaved changes from last commit
    [vh_21c.brd, vh_21c.sch]
2020-05-19 Updated BOM
    [BOM.ods, Mini BOM.ods]
2020-05-19 Added 2.1 case STLs
    [2.5mm Jack.stl, Bottom Snugger.stl, Bottom.stl, Buttons.stl, Buttons_Vibhub 2.1c Case rev F v2_Config_Buttons.stl, Buttons_Vibhub 2.1c Case rev F v2_Power_Buttons.stl, Middle.stl, Top Single.stl]
2020-05-19 Fixed silkscreen on D1 and D5
    [vh_21c.brd, vh_21c.sch]
2020-05-19 Added LCSL BOM file (BOM tool kinda works)
    [LCSC_Bom.xlsx]
2020-05-22 Added tighter battery cover (negative tolerance) Added 2 variants of the top with inner logo closer to the front face (0.2mm vs 0.4mm)
    [Bottom_Tight.stl, Top_Vibhub 2.1c Case rev F v10_11_Top.stl, Top_Vibhub 2.1c Case rev F v10_21_Top.stl, Top_Vibhub 2.1c Case rev F v10_22_Top.stl, Top_Vibhub 2.1c Case rev F v10_31_Top.stl, Top_Vibhub 2.1c Case rev F v10_32_Top.stl, Top_Vibhub 2.1c Case rev F v10_33_Top.stl, Top_Vibhub 2.1c Case rev F v10_41_Top.stl]
2021-03-01 bump version
    [Configuration.h]
2021-03-02 errant include
    [Configuration.h]
2021-03-12 Added schematic pngs
2022-04-14 Added platformio support Fixed various compile issues Fixed custom head extension construction Removed outdated Ticker-esp32 depend Updated external lib list Updated .gitignore for vscode
    [Configuration.h]
